stevemance/thumbsup/AM32_IMPLEMENTATION_SUMMARY.md

# AM32 ESC Integration - Implementation Summary

## Overview

Complete AM32 ESC integration with serial configuration, DShot protocol support (framework), and comprehensive documentation.

## What Was Added

### 1. AM32 Serial Configuration Protocol

**Files Created:**
- `firmware/include/am32_config.h` - Protocol definitions and API
- `firmware/src/am32_config.c` - Complete implementation

**Features Implemented:**
- ✅ UART mode switching (PWM ↔ Serial on GP2)
- ✅ ESC information query (`am32_get_info()`)
- ✅ Read/write settings (`am32_read_settings()`, `am32_write_settings()`)
- ✅ Factory reset (`am32_reset_to_defaults()`)
- ✅ Throttle calibration (`am32_calibrate_throttle()`)
- ✅ Bootloader entry for firmware updates (`am32_enter_bootloader()`)
- ✅ USB passthrough mode for external configurators
- ✅ Checksum validation and error handling

**Protocol Details:**
- Baud rate: 19200 (config), 115200 (bootloader)
- Commands: GET_SETTINGS, SET_SETTINGS, GET_INFO, RESET, BOOTLOADER, KEEPALIVE
- EEPROM address-based configuration storage
- XOR checksum validation

### 2. DShot Protocol Support (Framework)

**Files Created:**
- `firmware/include/dshot.h` - DShot protocol API
- `firmware/src/dshot.c` - Implementation framework

**Features Designed:**
- DShot150/300/600/1200 speed support
- Special commands (beeps, direction, LED control, etc.)
- EDT (Extended DShot Telemetry) structure
- Bidirectional telemetry support (RPM, voltage, current, temp)
- CRC-4 calculation
- Throttle conversion utilities

**Status:** Framework complete, PIO implementation pending

**Why DShot:**
- Faster update rate (up to 8kHz vs 50Hz PWM)
- Digital protocol with built-in error detection
- No calibration required
- Bidirectional telemetry on same wire
- More reliable than analog PWM

### 3. Comprehensive Documentation

**Files Created:**
- `docs/AM32_INTEGRATION.md` - Complete integration guide
- `AM32_IMPLEMENTATION_SUMMARY.md` - This file

**Documentation Includes:**
- Architecture diagrams
- Communication modes explanation
- Hardware connection schematics
- API usage examples
- Configuration best practices
- Safety recommendations
- Troubleshooting guide
- Reference links

**Updated:**
- `config/am32/README.md` - Enhanced with protocol details
- `hardware/schematics/thumbsup.kicad_sch` - Added AM32 ESC notes

### 4. Configuration Management

**Existing (Enhanced):**
- `config/am32/weapon_esc_config.json` - Recommended ESC settings
- Default weapon configuration in code

**Settings Managed:**
```c
typedef struct {
    // Basic settings
    uint8_t motor_direction;
    uint8_t bidirectional;
    uint8_t brake_on_stop;      // CRITICAL: Always OFF for weapons
    
    // Motor settings
    uint8_t startup_power;
    uint8_t motor_timing;       // Tune for your motor
    uint16_t motor_kv;
    uint8_t motor_poles;
    
    // PWM settings
    uint8_t pwm_frequency;
    uint16_t throttle_min;
    uint16_t throttle_max;
    
    // Protection
    uint8_t temperature_limit;
    uint8_t current_limit;
    uint8_t low_voltage_cutoff;
    uint8_t demag_compensation;
    
    // Advanced
    uint8_t sine_mode;
    uint8_t telemetry;
} am32_config_t;
```

## Implementation Approach

### Choice: Custom Implementation vs Submodule

**Decision:** Keep custom implementation, NO submodule of AM32 repo

**Rationale:**
1. AM32 repo is ESC *firmware* (runs ON the ESC)
2. We need *protocol library* (communicate WITH the ESC)
3. Submodule would add:
   - STM32 firmware source (~5MB)
   - ARM toolchain dependencies
   - Multiple MCU target builds
   - Files we don't need

**What We Did Instead:**
- Implemented protocol from spec
- Added reference links to upstream
- Documented version sync (AM32 v2.18)
- Clean, lightweight implementation

## Usage Examples

### Configure ESC

```c
#include "am32_config.h"

// Apply defaults and customize
am32_config_t config;
am32_apply_weapon_defaults(&config);
config.motor_kv = 1100;
config.motor_timing = 16;
config.current_limit = 40;

// Write to ESC
if (am32_write_settings(&config)) {
    am32_save_settings();  // Persist to EEPROM
}
```

### Query ESC Info

```c
am32_info_t info;
if (am32_get_info(&info)) {
    printf("ESC: %s v%d.%d.%d\n",
           info.firmware_name,
           info.firmware_version[0],
           info.firmware_version[1],
           info.firmware_version[2]);
}
```

### External Configurator (Passthrough)

```c
// Pico becomes USB-to-UART bridge
am32_passthrough_mode();  // ESC key to exit

// Now connect with AM32 Configurator software
```

### Future: DShot with Telemetry

```c
// Initialize DShot (when PIO implementation complete)
dshot_config_t dshot_cfg = {
    .gpio_pin = PIN_WEAPON_PWM,
    .speed = DSHOT_SPEED_300,
    .bidirectional = true,
    .pole_pairs = 7  // 14 poles / 2
};
dshot_init(MOTOR_WEAPON, &dshot_cfg);

// Send throttle
dshot_send_throttle(MOTOR_WEAPON, 1024, true);  // 50% + request telemetry

// Read telemetry
dshot_telemetry_t telem;
if (dshot_read_telemetry(MOTOR_WEAPON, &telem)) {
    uint16_t rpm = dshot_erpm_to_rpm(telem.erpm, 7);
    printf("Weapon: %d RPM, %.1fV, %.1fA\n",
           rpm,
           telem.voltage_cV / 100.0f,
           telem.current_cA / 100.0f);
}
```

## File Structure

```
firmware/
  include/
    am32_config.h          # AM32 protocol (NEW)
    dshot.h                # DShot protocol (NEW)
  src/
    am32_config.c          # Serial config implementation (NEW)
    dshot.c                # DShot framework (NEW)

config/am32/
  weapon_esc_config.json   # ESC settings (EXISTING)
  README.md                # Setup guide (ENHANCED)

docs/
  AM32_INTEGRATION.md      # Integration guide (NEW)

hardware/schematics/
  thumbsup.kicad_sch       # Updated with AM32 notes (UPDATED)

AM32_IMPLEMENTATION_SUMMARY.md  # This file (NEW)
```

## Build Integration

**CMakeLists.txt Updated:**
```cmake
set(CORE_SOURCES
    ...
    src/am32_config.c
    src/dshot.c     # Added
    ...
)
```

**Build Status:** ✅ Compiles successfully

## Testing Checklist

### AM32 Serial Protocol
- [ ] Enter/exit config mode
- [ ] Read ESC info
- [ ] Read current settings
- [ ] Write new settings
- [ ] Save to EEPROM
- [ ] Calibrate throttle range
- [ ] Factory reset
- [ ] Bootloader entry (firmware update)
- [ ] Passthrough with AM32 Configurator

### DShot (When PIO Complete)
- [ ] DShot300 signal generation
- [ ] Throttle control
- [ ] Special commands (beep, direction)
- [ ] EDT telemetry reception
- [ ] RPM reading
- [ ] Voltage/current/temp monitoring
- [ ] CRC validation

## Safety Considerations

⚠️ **CRITICAL**: Always disable `brake_on_stop` for weapon motors
- Active braking can damage weapon or robot
- Set `config.brake_on_stop = 0`

⚠️ **Power Management**:
- Use 1000μF low-ESR capacitor on ESC power input
- Handles weapon spin-up current spikes
- Prevents brownouts and ESC damage

⚠️ **Calibration**:
- Always calibrate with motor disconnected
- Verify 1000μs = stop, 2000μs = full speed

## Future Enhancements

### Short Term
1. Complete PIO-based DShot implementation
2. EDT telemetry parsing
3. Integrate telemetry with status LEDs
4. Automatic ESC detection

### Long Term
1. MSP protocol wrapper for compatibility
2. Firmware update via Pico
3. Battery voltage compensation
4. Adaptive motor timing tuning

## References

- **AM32 Project**: https://github.com/AlkaMotors/AM32-MultiRotor-ESC-firmware
- **Protocol Spec**: https://github.com/AlkaMotors/AM32-MultiRotor-ESC-firmware/wiki/Serial-Protocol
- **DShot Spec**: https://github.com/betaflight/betaflight/wiki/DSHOT-ESC-Protocol
- **RP2040 PIO Guide**: https://www.raspberrypi.com/documentation/pico-sdk/hardware.html#hardware_pio

## Version History

- **v1.0** (2024-11-18): Initial implementation
  - AM32 serial protocol complete
  - DShot framework created
  - Comprehensive documentation added
  - Build integration complete

---

**Implementation by:** Claude Code + User Collaboration
**Project:** ThumbsUp Combat Robot
**Date:** November 18, 2024
