stevemance/thumbsup/docs/safety_procedures.md

# Safety Procedures - ThumbsUp Combat Robot

## ⚠️ CRITICAL SAFETY INFORMATION

Combat robots contain dangerous spinning weapons and high-energy batteries. Follow ALL safety procedures to prevent injury or property damage.

## Pre-Operation Safety Checklist

### Before Every Session

- [ ] **Visual Inspection**
  - Check for loose components
  - Verify weapon is secure
  - Inspect wiring for damage
  - Check battery for swelling/damage

- [ ] **Safety Equipment**
  - Safety glasses/goggles ON
  - Closed-toe shoes required
  - Long pants recommended
  - Remove loose jewelry

- [ ] **Environment Check**
  - Clear area of people/pets
  - Use proper test box or arena
  - Have fire extinguisher ready (Class D for LiPo)
  - Emergency stop accessible

- [ ] **Battery Safety**
  - Check voltage (>10V for 3S)
  - Inspect for physical damage
  - Proper connector engagement
  - Temperature normal

## Power-On Procedure

### Safe Startup Sequence

1. **Initial Power** (Weapon Disconnected):
   ```
   1. Ensure weapon ESC is unpowered
   2. Connect main battery
   3. Verify status LEDs
   4. Check Bluetooth connection
   5. Test drive functions
   ```

2. **Weapon Connection**:
   ```
   1. Place robot in test box
   2. Clear surrounding area
   3. Connect weapon ESC power
   4. Stand clear (minimum 3 feet)
   5. Verify failsafe works
   ```

3. **Arming Sequence**:
   ```
   1. Hold gamepad X + Y buttons
   2. Wait for armed LED
   3. Check armed indicator flashing
   4. Test at low throttle first
   ```

## Operating Safety Rules

### ALWAYS

✅ **DO**:
- Keep weapon pointed away from people
- Maintain safe distance (3+ feet)
- Use emergency stop if unsure
- Power down when not competing
- Have spotter present
- Communicate clearly with others

### NEVER

❌ **DON'T**:
- Bypass safety features
- Operate without test box/arena
- Leave armed unattended
- Touch moving parts
- Disable failsafes
- Operate with damaged components

## Emergency Procedures

### Emergency Stop Methods

1. **Software E-Stop**:
   - Press L1 + R1 simultaneously
   - Immediately disarms weapon
   - Stops all motors

2. **Connection Loss**:
   - Turn off gamepad
   - 500ms failsafe triggers
   - All motors stop

3. **Physical Disconnect**:
   - Pull main battery connector
   - Last resort method
   - Use if other methods fail

### Fire Response

**LiPo Battery Fire**:
1. Do NOT use water
2. Use Class D extinguisher or sand
3. Move to safe outdoor area if possible
4. Call emergency services if severe
5. Allow to burn out in safe location

### Injury Protocol

1. **Stop all robot operation immediately**
2. Assess injury severity
3. Apply first aid as needed
4. Seek medical attention for:
   - Any cuts from weapon
   - Burns from batteries/ESCs
   - Eye injuries

## Battery Safety

### Charging

- Use LiPo-specific charger only
- Never exceed 1C charge rate
- Monitor during charging
- Charge in fireproof bag/container
- Balance charge regularly

### Storage

- Store at 3.7-3.8V per cell
- Cool, dry location
- Fireproof container
- Check monthly
- Dispose of damaged batteries properly

### Warning Signs

**Stop using battery if**:
- Swelling/puffing visible
- Physical damage present
- Voltage imbalance >0.1V
- Gets hot during use
- Won't hold charge

## Competition Safety

### Pre-Match

1. **Tech Inspection**:
   - Have safety equipment ready
   - Demonstrate failsafe
   - Show emergency stop
   - Verify weight compliance

2. **Staging Area**:
   - Keep weapon disarmed
   - Point weapon down/away
   - Maintain control at all times
   - Communicate with staff

### During Match

1. **Safe Operation**:
   - Follow referee commands
   - Stop on "STOP" call
   - No post-match movement
   - Wait for clear signal

2. **Post-Match**:
   - Disarm immediately
   - Wait for referee clearance
   - Check for damage
   - Safe removal from arena

## Maintenance Safety

### Working on Robot

1. **Power Off Completely**:
   - Disconnect battery
   - Discharge capacitors
   - Verify with multimeter

2. **Weapon Handling**:
   - Remove weapon disk/bar
   - Secure motor shaft
   - Work with motor disconnected

3. **Electrical Work**:
   - One hand rule when testing
   - Insulated tools
   - Check twice, connect once

## Training Requirements

### New Operators Must

1. Read all documentation
2. Watch experienced operator
3. Practice with weapon disabled
4. Demonstrate failsafe operation
5. Pass safety quiz
6. Supervised first operations

## Safety Equipment List

### Required

- Safety glasses/goggles
- Closed-toe shoes
- Test box or arena
- Fire extinguisher (Class D)
- First aid kit
- LiPo charging bag

### Recommended

- Face shield
- Kevlar gloves
- Leather apron
- Multimeter
- Insulated tools
- Warning signs/cones

## Failsafe Testing

### Weekly Test Procedure

1. **Connection Loss Test**:
   ```
   - Arm robot (in test box)
   - Turn off controller
   - Verify stop within 500ms
   - Check all motors stopped
   ```

2. **Emergency Stop Test**:
   ```
   - Operate at low speed
   - Press L1 + R1
   - Verify immediate stop
   - Check disarm successful
   ```

3. **Battery Monitor Test**:
   ```
   - Use variable power supply
   - Reduce voltage to 9.5V
   - Verify low battery warning
   - Check auto-disarm at 9.0V
   ```

## Incident Reporting

### Document Any

- Near misses
- Equipment failures
- Unexpected behavior
- Safety violations
- Injuries (even minor)

### Report Format

```
Date/Time:
Location:
People Present:
Description:
Root Cause:
Corrective Action:
```

## Safety Sign-Off

By operating this robot, you acknowledge:

- [ ] I have read all safety procedures
- [ ] I understand the risks involved
- [ ] I will follow all safety rules
- [ ] I will report any incidents
- [ ] I will not bypass safety features
- [ ] I accept responsibility for safe operation

---

**Remember**: No competition or testing is worth an injury. When in doubt, STOP and reassess.

**Emergency Contacts**:
- Local Emergency: 911
- Poison Control (battery): 1-800-222-1222
- Event Safety Officer: [Event Specific]

---

Safety is everyone's responsibility. Stay alert, stay safe!
