stevemance/thumbsup/firmware/tests/README.md

# Firmware One-Off Tests

This directory contains standalone firmware images for bench testing.
These are not part of the competition firmware and may bypass safety interlocks.

## Build

```bash
export PICO_SDK_PATH=/path/to/pico-sdk
cd firmware/tests
mkdir -p build && cd build
cmake ..
make dshot_beep_test dshot_spin_test dshot_telemetry_spin_test dshot_telemetry_hold_test dshot_telemetry_single_rpm_test dshot_telemetry_calibration_test am32_onewire_probe
```

## Flash (example)

```bash
picotool reboot -f -u
picotool load -x firmware/tests/build/dshot_spin_test.uf2
```

## Notes

- DShot tests use GP4 (PIN_WEAPON_PWM) and DShot300.
- Bidirectional telemetry is disabled in the spin test for stability.
- Use `dshot_telemetry_spin_test` for bidirectional telemetry experiments.
- Use `dshot_telemetry_hold_test` for a single-throttle hold window.
- Use `dshot_telemetry_single_rpm_test` for a fixed-throttle RPM + PSU current window.
- Use `dshot_telemetry_calibration_test` for multi-step throttle calibration holds.
- Use `am32_onewire_probe` to read AM32 settings over the single signal wire.
