stevemance/thumbsup/firmware/src/main.c

#include <stdio.h>
#include <stdlib.h>
#include <string.h>
#include <pico/stdlib.h>
#include <hardware/gpio.h>
#include <hardware/adc.h>
#include <hardware/watchdog.h>
#include "config.h"
#include "drive_hbridge.h"
#include "motor_control.h"
#include "drive.h"
#include "weapon.h"
#include "safety.h"
#include "status.h"
#include "am32_config.h"
#include "safety_test.h"
#include "integration_test.h"
#include "serial_gamepad.h"
#include "test_mode.h"
#include "hitl_overrides.h"

// Competition mode (Bluetooth) - diagnostic mode removed
#if !SERIAL_GAMEPAD
#include <pico/cyw43_arch.h>
#include <btstack_run_loop.h>
#include <uni.h>
#include "sdkconfig.h"
// Sanity check
#ifndef CONFIG_BLUEPAD32_PLATFORM_CUSTOM
#error "Pico W must use BLUEPAD32_PLATFORM_CUSTOM"
#endif
// Defined in bluetooth_platform.c
struct uni_platform* get_my_platform(void);
#endif

// Robot state is now managed in bluetooth_platform.c

static void init_hardware(void) {
    // Note: stdio_init_all() is called in main() before this function

#if BATTERY_ADC_ENABLED && !DRIVE_HBRIDGE
    adc_init();
    adc_gpio_init(PIN_BATTERY_ADC);
    adc_select_input(0);
#endif

#if SAFETY_BUTTON_ENABLED
    gpio_init(PIN_SAFETY_BUTTON);
    gpio_set_dir(PIN_SAFETY_BUTTON, GPIO_IN);
    gpio_pull_up(PIN_SAFETY_BUTTON);
#endif

#if !SERIAL_GAMEPAD
    printf("\n=================================\n");
    printf("  %s Combat Robot\n", ROBOT_NAME);
    printf("  Firmware v%s\n", FIRMWARE_VERSION);
    printf("=================================\n\n");
#endif

}

uint32_t read_battery_voltage(void) {
    uint32_t override_mv = 0;
    if (hitl_overrides_get_battery_mv(&override_mv)) {
        return override_mv;
    }

#if !BATTERY_ADC_ENABLED
    return BATTERY_MAX_VOLTAGE;  // ADC not wired — report nominal full voltage
#elif DRIVE_HBRIDGE
    // The drive module owns the ADC (round robin with the current senses).
    return drive_hb_battery_mv();
#endif

    uint16_t adc_raw = adc_read();

    // SAFETY: Validate ADC reading and prevent overflow
    if (adc_raw > 4095) {
        DEBUG_PRINT("WARNING: Invalid ADC reading %u\n", adc_raw);
        adc_raw = 4095;
    }

    // Use double precision to prevent intermediate overflow
    double voltage = ((double)adc_raw * BATTERY_ADC_SCALE / 4095.0) * BATTERY_DIVIDER * 1000.0;

    // SAFETY: Clamp result to reasonable range before converting to int
    if (voltage < 0.0) voltage = 0.0;
    if (voltage > 20000.0) voltage = 20000.0; // Max 20V for safety

    return (uint32_t)voltage;
}

// Battery monitoring and status functions moved to bluetooth_platform.c

static void check_config_mode_entry(void) {
    // Enter config mode if safety button held during boot
#if SAFETY_BUTTON_ENABLED
    if (!gpio_get(PIN_SAFETY_BUTTON)) {
#else
    if (false) {
#endif
        printf("\n=================================\n");
        printf("  AM32 Configuration Mode\n");
        printf("=================================\n\n");

        am32_init();

        printf("Options:\n");
        printf("1. Press 'C' to configure ESC\n");
        printf("2. Press 'P' for passthrough mode\n");
        printf("3. Press 'T' for throttle calibration\n");
        printf("4. Press 'D' to apply defaults\n");
        printf("5. Press any other key to exit\n\n");

        int c = getchar();

        switch (c) {
            case 'C':
            case 'c': {
                printf("Configuring AM32 ESC with weapon defaults...\n");
                am32_config_t config;
                am32_apply_weapon_defaults(&config);

                if (am32_enter_config_mode()) {
                    if (am32_write_settings(&config)) {
                        am32_save_settings();
                        printf("Configuration complete!\n");
                    } else {
                        printf("Configuration failed!\n");
                    }
                    am32_exit_config_mode();
                }
                break;
            }

            case 'P':
            case 'p':
                printf("Entering passthrough mode (ESC to exit)...\n");
                am32_passthrough_mode();
                break;

            case 'T':
            case 't':
                printf("Starting throttle calibration...\n");
                if (am32_enter_config_mode()) {
                    am32_calibrate_throttle();
                    am32_exit_config_mode();
                }
                break;

            case 'D':
            case 'd': {
                printf("Applying default weapon settings...\n");
                am32_config_t default_config;
                am32_apply_weapon_defaults(&default_config);
                if (am32_enter_config_mode()) {
                    am32_write_settings(&default_config);
                    am32_save_settings();
                    am32_exit_config_mode();
                }
                printf("Defaults applied!\n");
                break;
            }

            default:
                printf("Exiting config mode...\n");
                break;
        }

        printf("\nContinuing to normal operation...\n\n");
        sleep_ms(1000);
    }
}

int main() {
    stdio_init_all();

    // Wait a bit for USB connection
    sleep_ms(2000);

#if !SERIAL_GAMEPAD
    printf("\n\n*** MAIN STARTING ***\n");
    printf("Build mode: COMPETITION\n");
    printf("Motor output disabled: %d\n", DISABLE_MOTOR_OUTPUT);
#endif

    init_hardware();

#if INTEGRATION_TEST_AUTO
    printf("\n=================================\n");
    printf("  INTEGRATION TEST BUILD\n");
    printf("=================================\n\n");
    printf("Skipping Bluetooth/WiFi init\n");
#elif SERIAL_GAMEPAD
    // SERIAL_GAMEPAD build: skip Bluetooth/WiFi init quietly to avoid blocking USB output.
#else
    #if BUILD_MODE_DIAGNOSTIC
        // DIAGNOSTIC MODE BUILD

        // Wait for USB serial connection
        for (int i = 0; i < 3; i++) {
            printf("Starting diagnostic mode in %d...\n", 3-i);
            sleep_ms(1000);
        }

        printf("\n=================================\n");
        printf("  DIAGNOSTIC MODE BUILD\n");
        printf("=================================\n\n");

        // Initialize for WiFi (diagnostic mode)
        if (cyw43_arch_init_with_country(CYW43_COUNTRY_USA)) {
            printf("Failed to initialize WiFi\n");
            return -1;
        }
        printf("WiFi initialized for diagnostic mode\n");
    #else
        // COMPETITION MODE BUILD
        printf("\n=================================\n");
        printf("  COMPETITION MODE BUILD\n");
        printf("=================================\n\n");

        // Initialize for Bluetooth (competition mode)
        if (cyw43_arch_init()) {
            printf("Failed to initialize Bluetooth\n");
            return -1;
        }
        printf("Bluetooth initialized for competition mode\n");
    #endif

    // Turn-on LED. Turn it off once init is done.
    cyw43_arch_gpio_put(CYW43_WL_GPIO_LED_PIN, 1);
#endif

    // COMPETITION MODE - Run Bluetooth gamepad control
#if !SERIAL_GAMEPAD
        printf("\n*** COMPETITION MODE ***\n");
        printf("Starting Bluetooth initialization...\n");
#endif

        // Check if we should enter AM32 config mode
#if !SERIAL_GAMEPAD
        printf("Checking for config mode...\n");
        check_config_mode_entry();
#endif

        // Initialize AM32 config
#if !SERIAL_GAMEPAD
        printf("Initializing AM32...\n");
#endif
        am32_init();

        // Initialize motor control system before safety tests
#if !SERIAL_GAMEPAD
        printf("Initializing motor control system...\n");
#endif
        #if SERIAL_GAMEPAD
        test_mode_init();
        #endif
        motor_control_init();

        // Initialize other subsystems needed for tests
        weapon_init();
        drive_init();
        safety_init();
        #if !INTEGRATION_TEST_AUTO
        status_init();
        #endif

        // SAFETY: Run comprehensive safety tests
#if !SERIAL_GAMEPAD
        printf("Running safety validation tests...\n");
        if (!run_safety_tests()) {
            printf("\n*** CRITICAL SAFETY FAILURE ***\n");
            printf("Robot safety tests failed!\n");
            printf("DO NOT OPERATE - SYSTEM UNSAFE\n");
            printf("*******************************\n\n");

            // Flash all LEDs rapidly to indicate unsafe condition
            status_emergency_flash();
            while (true) {
                status_update();
                sleep_ms(50);
            }
        }
        printf("Safety tests passed - system ready\n");
#endif

#if !SERIAL_GAMEPAD
        if (integration_test_run_if_requested(5000)) {
            printf("Integration test complete - halting normal startup\n");
            while (true) {
                status_update();
                sleep_ms(100);
            }
        }
#endif

#if SERIAL_GAMEPAD
        serial_gamepad_init();
        uint32_t last_status_ms = 0;

        while (true) {
            serial_gamepad_poll();
            motor_control_update();
            weapon_update();
            uint32_t now_ms = to_ms_since_boot(get_absolute_time());
            if ((now_ms - last_status_ms) >= STATUS_UPDATE_RATE) {
                status_update();
                last_status_ms = now_ms;
            }
            safety_update();
            sleep_ms(MAIN_LOOP_DELAY);
        }
#else
        // Must be called before uni_init()
        uni_platform_set_custom(get_my_platform());

        // Initialize BP32
        printf("About to call uni_init()...\n");
        uni_init(0, NULL);
        printf("uni_init() completed successfully\n");

        printf("ThumbsUp robot initialized. Starting Bluepad32...\n");

        // Don't enable watchdog yet - wait for first controller connection
        // The bluetooth_platform.c will enable it after first gamepad connects
        printf("Watchdog will be enabled after first controller connection\n");

        // Turn off onboard LED
        cyw43_arch_gpio_put(CYW43_WL_GPIO_LED_PIN, 0);

        // Does not return - BTstack takes over
        btstack_run_loop_execute();
#endif

    return 0;
}
