stevemance/thumbsup/firmware/src/motor_control.c

#include "motor_control.h"
#include "config.h"
#include "system_status.h"
#include "hardware/pwm.h"
#include "hardware/clocks.h"
#include "hardware/gpio.h"
#if DRIVE_HBRIDGE
#include "drive_hbridge.h"
#endif
#include <stdio.h>
#include <stdlib.h>

static motor_config_t motors[MOTOR_COUNT];
static bool initialized = false;

static uint16_t speed_to_pulse(int8_t speed) {
    // SAFETY: Clamp input to prevent overflow
    speed = CLAMP(speed, -100, 100);

    const int16_t mid_pulse = PWM_NEUTRAL_PULSE;

    if (speed == 0) {
        return mid_pulse;
    }

    // SAFETY: Use 32-bit arithmetic to prevent overflow, then clamp result
    if (speed > 0) {
        int32_t pulse = mid_pulse + ((int32_t)speed * (PWM_MAX_PULSE - mid_pulse)) / 100;
        return (uint16_t)CLAMP(pulse, PWM_MIN_PULSE, PWM_MAX_PULSE);
    } else {
        int32_t pulse = mid_pulse + ((int32_t)speed * (mid_pulse - PWM_MIN_PULSE)) / 100;
        return (uint16_t)CLAMP(pulse, PWM_MIN_PULSE, PWM_MAX_PULSE);
    }
}

#if DRIVE_HBRIDGE
// Drive channels keep their servo-pulse interface (1000..2000 us, 1500 =
// stop) so callers are unchanged; the pulse maps linearly onto H-bridge duty.
static void hb_apply(motor_channel_t channel, uint16_t pulse_us) {
    if (channel == MOTOR_LEFT_DRIVE || channel == MOTOR_RIGHT_DRIVE) {
        drive_hb_set(channel, (int16_t)(((int32_t)pulse_us - PWM_NEUTRAL_PULSE) * 2));
    }
}
#endif

static void setup_pwm_pin(uint8_t pin, uint8_t* slice, uint8_t* channel) {
    // SAFETY: Validate pointer parameters
    if (slice == NULL || channel == NULL) {
        DEBUG_PRINT("CRITICAL: NULL pointer passed to setup_pwm_pin\n");
        return;
    }

    gpio_set_function(pin, GPIO_FUNC_PWM);
    *slice = pwm_gpio_to_slice_num(pin);
    *channel = pwm_gpio_to_channel(pin);

    pwm_config cfg = pwm_get_default_config();

    pwm_config_set_clkdiv(&cfg, (float)clock_get_hz(clk_sys) / PWM_TICK_HZ);
    pwm_config_set_wrap(&cfg, PWM_WRAP_VALUE - 1);

    pwm_init(*slice, &cfg, false);
}

static void init_weapon_pwm_disabled(void) {
    gpio_set_function(PIN_WEAPON_PWM, GPIO_FUNC_SIO);
    gpio_set_dir(PIN_WEAPON_PWM, GPIO_IN);
    gpio_pull_up(PIN_WEAPON_PWM);
}

bool motor_control_init(void) {
    if (initialized) {
        return true;
    }

#if DRIVE_HBRIDGE
    drive_hb_init();
    motors[MOTOR_LEFT_DRIVE].gpio_pin = PIN_HB_LEFT_IN1;
    motors[MOTOR_LEFT_DRIVE].reversed = false;
    motors[MOTOR_LEFT_DRIVE].pwm_enabled = false;   // owned by drive_hbridge
    motors[MOTOR_RIGHT_DRIVE].gpio_pin = PIN_HB_RIGHT_IN1;
    motors[MOTOR_RIGHT_DRIVE].reversed = true;  // Reversed because motor is mounted facing opposite direction
    motors[MOTOR_RIGHT_DRIVE].pwm_enabled = false;
#else
    motors[MOTOR_LEFT_DRIVE].gpio_pin = PIN_DRIVE_LEFT_PWM;
    motors[MOTOR_LEFT_DRIVE].reversed = false;
    setup_pwm_pin(PIN_DRIVE_LEFT_PWM,
                  &motors[MOTOR_LEFT_DRIVE].pwm_slice,
                  &motors[MOTOR_LEFT_DRIVE].pwm_channel);
    motors[MOTOR_LEFT_DRIVE].pwm_enabled = true;

    motors[MOTOR_RIGHT_DRIVE].gpio_pin = PIN_DRIVE_RIGHT_PWM;
    motors[MOTOR_RIGHT_DRIVE].reversed = true;  // Reversed because motor is mounted facing opposite direction
    setup_pwm_pin(PIN_DRIVE_RIGHT_PWM,
                  &motors[MOTOR_RIGHT_DRIVE].pwm_slice,
                  &motors[MOTOR_RIGHT_DRIVE].pwm_channel);
    motors[MOTOR_RIGHT_DRIVE].pwm_enabled = true;
#endif

    motors[MOTOR_WEAPON].gpio_pin = PIN_WEAPON_PWM;
    motors[MOTOR_WEAPON].reversed = false;
    motors[MOTOR_WEAPON].pwm_slice = 0;
    motors[MOTOR_WEAPON].pwm_channel = 0;
    motors[MOTOR_WEAPON].pwm_enabled = false;
    init_weapon_pwm_disabled();

    // CRITICAL SAFETY: Initialize all motors to safe states
    for (int i = 0; i < MOTOR_COUNT; i++) {
        if (i == MOTOR_WEAPON) {
            // Weapon motor MUST start with minimum pulse (off)
            motors[i].current_pulse_us = PWM_MIN_PULSE;
            motors[i].target_pulse_us = PWM_MIN_PULSE;
        } else {
            // Drive motors start at neutral (stopped)
            motors[i].current_pulse_us = PWM_NEUTRAL_PULSE;
            motors[i].target_pulse_us = PWM_NEUTRAL_PULSE;
        }
        if (motors[i].pwm_enabled) {
            uint32_t pulse_cycles = motors[i].current_pulse_us;
            #if !DISABLE_MOTOR_OUTPUT
            pwm_set_chan_level(motors[i].pwm_slice, motors[i].pwm_channel, pulse_cycles);
            #else
            printf("MOTOR: Would set %d to %d cycles (DISABLED)\n", i, pulse_cycles);
            #endif
            pwm_set_enabled(motors[i].pwm_slice, true);
        }
    }

    initialized = true;
    DEBUG_PRINT("Motor control initialized\n");

    return true;
}

bool motor_control_update(void) {
#if DRIVE_HBRIDGE
    drive_hb_update();
#endif
    if (!initialized) {
        return false;
    }

    for (int i = 0; i < MOTOR_COUNT; i++) {
        if (!motors[i].pwm_enabled) {
            continue;
        }
        if (motors[i].current_pulse_us != motors[i].target_pulse_us) {
            int16_t diff = motors[i].target_pulse_us - motors[i].current_pulse_us;
            int16_t step = 10;

            if (abs(diff) <= step) {
                motors[i].current_pulse_us = motors[i].target_pulse_us;
            } else if (diff > 0) {
                motors[i].current_pulse_us += step;
            } else {
                motors[i].current_pulse_us -= step;
            }

            uint32_t pulse_cycles = motors[i].current_pulse_us;
            #if !DISABLE_MOTOR_OUTPUT
            pwm_set_chan_level(motors[i].pwm_slice, motors[i].pwm_channel, pulse_cycles);
            #else
            // Log what we would be sending for testing
            if (motors[i].current_pulse_us != PWM_NEUTRAL_PULSE && i != MOTOR_WEAPON) {
                printf("MOTOR %d: %dus\n", i, motors[i].current_pulse_us);
            } else if (i == MOTOR_WEAPON && motors[i].current_pulse_us != PWM_MIN_PULSE) {
                printf("WEAPON: %dus\n", motors[i].current_pulse_us);
            }
            #endif
        }
    }

    return true;
}

// Changes the drive PWM frame rate at runtime (HITL experiments).  Pulse widths
// stay in microseconds, so only the frame period changes.
bool motor_control_set_drive_frame_rate(uint32_t hz) {
    if (!initialized || hz < 50 || hz > 490 || DRIVE_HBRIDGE) {
        return false;
    }
    const motor_channel_t drive[] = {MOTOR_LEFT_DRIVE, MOTOR_RIGHT_DRIVE};
    for (int i = 0; i < 2; i++) {
        pwm_set_wrap(motors[drive[i]].pwm_slice, (uint16_t)(PWM_TICK_HZ / hz - 1));
    }
    return true;
}

bool motor_control_set_pulse(motor_channel_t channel, uint16_t pulse_us) {
    if (!initialized || channel >= MOTOR_COUNT) {
        DEBUG_PRINT("Motor control error: invalid channel %d\n", channel);
        return false;
    }

    if (channel == MOTOR_WEAPON && !motors[channel].pwm_enabled) {
        motors[channel].current_pulse_us = PWM_MIN_PULSE;
        motors[channel].target_pulse_us = PWM_MIN_PULSE;
        return false;
    }

    // SAFETY: Additional validation for weapon motor
    if (channel == MOTOR_WEAPON) {
        // Weapon motor can only receive MIN_PULSE (off) when not properly armed
        if (system_failsafe_active() || !system_is_armed()) {
            if (pulse_us != PWM_MIN_PULSE) {
                DEBUG_PRINT("SAFETY: Weapon pulse blocked - not armed or failsafe active\n");
                pulse_us = PWM_MIN_PULSE;
            }
        }
    }

    // Strict pulse validation with logging
    if (pulse_us < PWM_MIN_PULSE || pulse_us > PWM_MAX_PULSE) {
        DEBUG_PRINT("Motor control error: invalid pulse %d for channel %d\n", pulse_us, channel);
        pulse_us = CLAMP(pulse_us, PWM_MIN_PULSE, PWM_MAX_PULSE);
    }

    // Apply immediately.  The drive ESCs get the new width at the next PWM
    // frame; any ramping here adds directly to stick-to-wheel latency.
    motors[channel].target_pulse_us = pulse_us;
#if DRIVE_HBRIDGE
    if (channel != MOTOR_WEAPON) {
        motors[channel].current_pulse_us = pulse_us;
        #if !DISABLE_MOTOR_OUTPUT
        hb_apply(channel, pulse_us);
        #endif
        return true;
    }
#endif
    if (motors[channel].pwm_enabled && motors[channel].current_pulse_us != pulse_us) {
        motors[channel].current_pulse_us = pulse_us;
        #if !DISABLE_MOTOR_OUTPUT
        pwm_set_chan_level(motors[channel].pwm_slice, motors[channel].pwm_channel, pulse_us);
        #endif
    }

    return true;
}

bool motor_control_set_speed(motor_channel_t channel, int8_t speed) {
    if (!initialized || channel >= MOTOR_COUNT) {
        return false;
    }

    int8_t original_speed = speed;
    speed = CLAMP(speed, -100, 100);

    if (motors[channel].reversed) {
        speed = -speed;
    }

    uint16_t pulse = speed_to_pulse(speed);

#ifdef DEBUG_MODE
    // DEBUG: Log motor commands (only for drive motors)
    static uint32_t last_motor_debug = 0;
    uint32_t now = to_ms_since_boot(get_absolute_time());
    if (now - last_motor_debug > 500 && channel < MOTOR_WEAPON) {
        if (original_speed != 0) {
            const char* name = (channel == MOTOR_LEFT_DRIVE) ? "LEFT" : "RIGHT";
            printf("MOTOR %s: speed=%d pulse=%dus\n", name, speed, pulse);
        }
        if (channel == MOTOR_RIGHT_DRIVE) {
            last_motor_debug = now;
        }
    }
#endif

    return motor_control_set_pulse(channel, pulse);
}

void motor_control_stop_all(void) {
    if (!initialized) {
        return;
    }

    for (int i = 0; i < MOTOR_COUNT; i++) {
        if (i == MOTOR_WEAPON) {
            motors[i].target_pulse_us = PWM_MIN_PULSE;
            motors[i].current_pulse_us = PWM_MIN_PULSE;
        } else {
            motors[i].target_pulse_us = PWM_NEUTRAL_PULSE;
            motors[i].current_pulse_us = PWM_NEUTRAL_PULSE;
#if DRIVE_HBRIDGE
            hb_apply((motor_channel_t)i, PWM_NEUTRAL_PULSE);
#endif
        }

        if (motors[i].pwm_enabled) {
            uint32_t pulse_cycles = motors[i].current_pulse_us;
            #if !DISABLE_MOTOR_OUTPUT
            pwm_set_chan_level(motors[i].pwm_slice, motors[i].pwm_channel, pulse_cycles);
            #endif
        }
    }
}

uint16_t motor_control_get_pulse(motor_channel_t channel) {
    if (!initialized || channel >= MOTOR_COUNT) {
        return PWM_NEUTRAL_PULSE;
    }

    return motors[channel].current_pulse_us;
}

uint16_t motor_control_get_target_pulse(motor_channel_t channel) {
    if (!initialized || channel >= MOTOR_COUNT) {
        return PWM_NEUTRAL_PULSE;
    }

    return motors[channel].target_pulse_us;
}

void motor_control_emergency_stop(void) {
    motor_control_stop_all();

    for (int i = 0; i < MOTOR_COUNT; i++) {
        if (motors[i].pwm_enabled) {
            pwm_set_enabled(motors[i].pwm_slice, false);
        }
    }

    initialized = false;
    DEBUG_PRINT("Emergency stop activated!\n");
}

bool motor_control_enable_weapon_pwm(void) {
    if (!initialized) {
        return false;
    }
    if (motors[MOTOR_WEAPON].pwm_enabled) {
        return true;
    }

    setup_pwm_pin(PIN_WEAPON_PWM,
                  &motors[MOTOR_WEAPON].pwm_slice,
                  &motors[MOTOR_WEAPON].pwm_channel);
    motors[MOTOR_WEAPON].pwm_enabled = true;
    motors[MOTOR_WEAPON].current_pulse_us = PWM_MIN_PULSE;
    motors[MOTOR_WEAPON].target_pulse_us = PWM_MIN_PULSE;

    uint32_t pulse_cycles = PWM_MIN_PULSE;
    #if !DISABLE_MOTOR_OUTPUT
    pwm_set_chan_level(motors[MOTOR_WEAPON].pwm_slice,
                       motors[MOTOR_WEAPON].pwm_channel,
                       pulse_cycles);
    #endif
    pwm_set_enabled(motors[MOTOR_WEAPON].pwm_slice, true);
    return true;
}

void motor_control_disable_weapon_pwm(void) {
    if (!initialized) {
        return;
    }
    motors[MOTOR_WEAPON].pwm_enabled = false;
    motors[MOTOR_WEAPON].current_pulse_us = PWM_MIN_PULSE;
    motors[MOTOR_WEAPON].target_pulse_us = PWM_MIN_PULSE;
}
