stevemance/thumbsup/firmware/src/drive.c

#include "drive.h"
#include "motor_control.h"
#include "config.h"
#include <stdio.h>
#include <stdlib.h>
#include <math.h>

static uint8_t current_expo = DRIVE_EXPO;
static bool drive_enabled = false;

int8_t drive_apply_expo(int8_t input, uint8_t expo) {
    // SAFETY: Validate inputs to prevent overflow
    if (input == 0 || expo == 0) {
        return input;
    }

    // Clamp expo to valid range
    expo = expo > 100 ? 100 : expo;

    float normalized = (float)input / 127.0f;
    float expo_factor = (float)expo / 100.0f;

    float linear = normalized;
    float cubic = normalized * normalized * normalized;

    // Cubic of negative is already negative, so no need to invert
    float output = linear * (1.0f - expo_factor) + cubic * expo_factor;

    // SAFETY: Clamp output to valid int8_t range
    float result = output * 127.0f;
    if (result > 127.0f) result = 127.0f;
    if (result < -127.0f) result = -127.0f;

    return (int8_t)result;
}

drive_output_t drive_mix(int8_t forward, int8_t turn) {
    drive_output_t output = {0, 0}; // SAFETY: Initialize to safe defaults

    // SAFETY: Validate inputs
    forward = CLAMP(forward, -127, 127);
    turn = CLAMP(turn, -127, 127);

    int8_t forward_before_expo = forward;
    int8_t turn_before_expo = turn;

    forward = drive_apply_expo(forward, current_expo);
    turn = drive_apply_expo(turn, TURN_EXPO);

#ifdef DEBUG_MODE
    // DEBUG: Log expo transformation
    static uint32_t last_expo_debug = 0;
    uint32_t now = to_ms_since_boot(get_absolute_time());
    if (now - last_expo_debug > 500) {
        if (forward_before_expo != 0 || turn_before_expo != 0) {
            printf("EXPO: F %d→%d, T %d→%d\n",
                   forward_before_expo, forward, turn_before_expo, turn);
        }
        last_expo_debug = now;
    }
#endif

    // SAFETY: Use 32-bit arithmetic to prevent overflow during scaling
    // Input range is -127 to +127, scale to percentage values
    // Forward: scale to -100 to +100 (MAX_DRIVE_SPEED = 100%)
    // Turn: scale to MAX_TURN_SPEED (50% = reduced turn sensitivity for better control)
    int32_t scaled_forward = ((int32_t)forward * MAX_DRIVE_SPEED) / 127;
    int32_t scaled_turn = ((int32_t)turn * MAX_TURN_SPEED) / 127;

    // SAFETY: Clamp after scaling to prevent overflow
    scaled_forward = CLAMP(scaled_forward, -100, 100);
    scaled_turn = CLAMP(scaled_turn, -100, 100);

    int32_t left = scaled_forward + scaled_turn;
    int32_t right = scaled_forward - scaled_turn;

    // SAFETY: Find max value safely
    int32_t max_val = (left < 0 ? -left : left);
    int32_t right_abs = (right < 0 ? -right : right);
    if (right_abs > max_val) max_val = right_abs;

    if (max_val > 100) {
        // SAFETY: Use double precision for scaling calculation
        double scale = 100.0 / (double)max_val;
        left = (int32_t)(left * scale);
        right = (int32_t)(right * scale);
    }

    output.left_speed = (int8_t)CLAMP(left, -100, 100);
    output.right_speed = (int8_t)CLAMP(right, -100, 100);

#ifdef DEBUG_MODE
    // DEBUG: Log final output speeds with real units
    static uint32_t last_mix_debug = 0;
    uint32_t now2 = to_ms_since_boot(get_absolute_time());
    if (now2 - last_mix_debug > 500) {
        if (output.left_speed != 0 || output.right_speed != 0) {
            float left_ms = PWM_PERCENT_TO_MS(output.left_speed);
            float right_ms = PWM_PERCENT_TO_MS(output.right_speed);
            int left_rpm = PWM_PERCENT_TO_RPM(output.left_speed);
            int right_rpm = PWM_PERCENT_TO_RPM(output.right_speed);
            printf("MIX: L=%d%% (%.2fm/s, %dRPM) R=%d%% (%.2fm/s, %dRPM)\n",
                   output.left_speed, left_ms, left_rpm,
                   output.right_speed, right_ms, right_rpm);
        }
        last_mix_debug = now2;
    }
#endif

    return output;
}

bool drive_init(void) {
    drive_enabled = true;
    current_expo = DRIVE_EXPO;

    motor_control_set_speed(MOTOR_LEFT_DRIVE, 0);
    motor_control_set_speed(MOTOR_RIGHT_DRIVE, 0);

    DEBUG_PRINT("Drive system initialized with expo=%d\n", current_expo);

    return true;
}

void drive_update(drive_control_t* control) {
    // SAFETY: Validate input parameters
    if (!control || !drive_enabled) {
        DEBUG_PRINT("Drive update: invalid parameters or disabled\n");
        drive_stop();
        return;
    }

    if (!control->enabled) {
        drive_stop();
        return;
    }

    // SAFETY: Additional validation of control inputs
    if (control->forward < -127 || control->forward > 127 ||
        control->turn < -127 || control->turn > 127) {
        DEBUG_PRINT("Drive update: invalid control values (%d, %d)\n",
                    control->forward, control->turn);
        drive_stop();
        return;
    }

    int8_t forward = control->forward;
    int8_t turn = control->turn;

    drive_output_t output = drive_mix(forward, turn);

    // SAFETY: Verify output is within expected range before sending to motors
    if (output.left_speed < -100 || output.left_speed > 100 ||
        output.right_speed < -100 || output.right_speed > 100) {
        DEBUG_PRINT("CRITICAL: Drive mix produced invalid output (%d, %d)\n",
                    output.left_speed, output.right_speed);
        drive_stop();
        return;
    }

    // Left/right differences (a damaged gearbox) are corrected per motor by
    // drive_hbridge's learned speed matching.
    motor_control_set_speed(MOTOR_LEFT_DRIVE, output.left_speed);
    motor_control_set_speed(MOTOR_RIGHT_DRIVE, output.right_speed);
}

void drive_stop(void) {
    motor_control_set_speed(MOTOR_LEFT_DRIVE, 0);
    motor_control_set_speed(MOTOR_RIGHT_DRIVE, 0);
}

void drive_set_expo(uint8_t expo_value) {
    current_expo = CLAMP(expo_value, 0, 100);
}
