stevemance/thumbsup/firmware/include/dshot.h

#ifndef DSHOT_H
#define DSHOT_H

#include <stdint.h>
#include <stdbool.h>
#include "motor_control.h"
#include "dshot_rx.h"

/**
 * DShot Protocol Implementation
 *
 * DShot is a digital ESC protocol that provides:
 * - More reliable communication than PWM
 * - Bidirectional telemetry (EDT - Extended DShot Telemetry)
 * - RPM, voltage, current, temperature feedback
 * - Faster update rates (up to 8kHz)
 *
 * DShot Frame Structure:
 * - 11 bits throttle value (0-2047)
 * - 1 bit telemetry request
 * - 4 bits CRC
 * Total: 16 bits per frame
 *
 * DShot Speeds:
 * - DShot150: 150kbit/s (6.67μs per bit)
 * - DShot300: 300kbit/s (3.33μs per bit)  ← Recommended for RP2040
 * - DShot600: 600kbit/s (1.67μs per bit)
 * - DShot1200: 1200kbit/s (0.83μs per bit)
 */

// DShot speed configuration
typedef enum {
    DSHOT_SPEED_150  = 150,   // 150kbit/s - most reliable
    DSHOT_SPEED_300  = 300,   // 300kbit/s - recommended
    DSHOT_SPEED_600  = 600,   // 600kbit/s - high performance
    DSHOT_SPEED_1200 = 1200   // 1200kbit/s - maximum speed
} dshot_speed_t;

// DShot special commands (throttle = 0, command in bits)
typedef enum {
    DSHOT_CMD_MOTOR_STOP        = 0,     // Stop motor
    DSHOT_CMD_BEEP1             = 1,     // Beep pattern 1
    DSHOT_CMD_BEEP2             = 2,     // Beep pattern 2
    DSHOT_CMD_BEEP3             = 3,     // Beep pattern 3
    DSHOT_CMD_BEEP4             = 4,     // Beep pattern 4
    DSHOT_CMD_BEEP5             = 5,     // Beep pattern 5
    DSHOT_CMD_ESC_INFO          = 6,     // Request ESC info
    DSHOT_CMD_SPIN_DIRECTION_1  = 7,     // Rotate direction 1
    DSHOT_CMD_SPIN_DIRECTION_2  = 8,     // Rotate direction 2
    DSHOT_CMD_3D_MODE_OFF       = 9,     // Disable 3D mode
    DSHOT_CMD_3D_MODE_ON        = 10,    // Enable 3D mode
    DSHOT_CMD_SETTINGS_REQUEST  = 11,    // Request settings
    DSHOT_CMD_SAVE_SETTINGS     = 12,    // Save settings to EEPROM
    DSHOT_CMD_EXTENDED_TELEMETRY_ENABLE  = 13, // Enable extended telemetry
    DSHOT_CMD_EXTENDED_TELEMETRY_DISABLE = 14, // Disable extended telemetry
    DSHOT_CMD_SPIN_DIRECTION_NORMAL   = 20,  // Normal rotation
    DSHOT_CMD_SPIN_DIRECTION_REVERSED = 21,  // Reversed rotation
    DSHOT_CMD_LED0_ON           = 22,    // LED 0 on
    DSHOT_CMD_LED1_ON           = 23,    // LED 1 on
    DSHOT_CMD_LED2_ON           = 24,    // LED 2 on
    DSHOT_CMD_LED3_ON           = 25,    // LED 3 on
    DSHOT_CMD_LED0_OFF          = 26,    // LED 0 off
    DSHOT_CMD_LED1_OFF          = 27,    // LED 1 off
    DSHOT_CMD_LED2_OFF          = 28,    // LED 2 off
    DSHOT_CMD_LED3_OFF          = 29,    // LED 3 off
    DSHOT_CMD_AUDIO_STREAM      = 30,    // Audio stream mode
    DSHOT_CMD_SILENT_MODE       = 31,    // Silent mode
} dshot_command_t;

// EDT (Extended DShot Telemetry) frame structure
typedef struct {
    uint32_t erpm;              // Electrical RPM (mechanical RPM × pole pairs)
    uint16_t voltage_cV;        // Voltage in centi-volts (12.6V = 1260)
    uint16_t current_cA;        // Current in centi-amps (10.5A = 1050)
    uint8_t temperature_C;      // Temperature in Celsius
    uint8_t crc;                // CRC checksum
    bool valid;                 // True if telemetry is valid
    uint32_t timestamp_ms;      // When telemetry was received
    uint8_t type;               // Kind of the most recent frame (dshot_frame_kind_t)
    uint16_t value;             // Raw 12-bit payload of the most recent frame
    uint8_t fresh;              // DSHOT_FRESH_* bits: fields updated by the most recent frame
    bool stopped;               // ESC reported "not turning" (0xFFF) more recently than an eRPM
    uint32_t erpm_ms;           // Per-field receive times (0 = never received)
    uint32_t voltage_ms;
    uint32_t current_ms;
    uint32_t temperature_ms;
} dshot_telemetry_t;

#define DSHOT_FRESH_ERPM  0x01   // eRPM or stopped frame
#define DSHOT_FRESH_VOLT  0x02
#define DSHOT_FRESH_CURR  0x04
#define DSHOT_FRESH_TEMP  0x08
#define DSHOT_FRESH_EVENT 0x10

// AM32 2.20 sends EDT current as amps/2 per step; the EDT spec (and newer
// AM32) use 1 A per step.  Centi-amps per step:
#ifndef DSHOT_EDT_CURRENT_CA_PER_STEP
#define DSHOT_EDT_CURRENT_CA_PER_STEP 50
#endif

// Receive statistics (bidirectional mode).
typedef struct {
    uint32_t frames_sent;          // telemetry-capable frames transmitted
    uint32_t replies_read;         // captures read from the PIO
    uint32_t results[DSHOT_RX_RESULT_COUNT];      // decode outcome counts
    uint32_t kinds[DSHOT_FRAME_KIND_COUNT];       // valid frames by kind
    uint32_t edt_enabled_events;   // 0xE00
    uint32_t edt_disabled_events;  // 0xEFF
    uint32_t discarded_words;      // RX words drained unread before a send
} dshot_rx_stats_t;

// DShot configuration
typedef struct {
    uint8_t gpio_pin;           // GPIO pin for DShot output
    dshot_speed_t speed;        // DShot speed (150/300/600/1200)
    bool bidirectional;         // Enable EDT telemetry
    uint8_t pole_pairs;         // Motor pole pairs (for RPM calculation)
} dshot_config_t;

/**
 * Initialize DShot for a motor channel
 *
 * @param motor Motor channel
 * @param config DShot configuration
 * @return true on success
 */
bool dshot_init(motor_channel_t motor, const dshot_config_t* config);

/**
 * Send DShot throttle command
 *
 * @param motor Motor channel
 * @param throttle Throttle value (0-2047, or 48-2047 for safety)
 * @param request_telemetry Request telemetry response
 * @return true on success
 */
bool dshot_send_throttle(motor_channel_t motor, uint16_t throttle, bool request_telemetry);

/**
 * Override CRC inversion for bidirectional bring-up.
 *
 * @param motor Motor channel
 * @param invert -1 = use config, 0 = normal CRC, 1 = inverted CRC
 */
void dshot_set_crc_invert_override(motor_channel_t motor, int8_t invert);

/**
 * Send DShot special command
 *
 * Must be sent 6+ times with 1ms delay to take effect
 *
 * @param motor Motor channel
 * @param cmd Special command
 * @return true on success
 */
bool dshot_send_command(motor_channel_t motor, dshot_command_t cmd);

/**
 * Read telemetry data (if bidirectional EDT enabled)
 *
 * @param motor Motor channel
 * @param telemetry Output telemetry data
 * @return true if new telemetry available
 */
bool dshot_read_telemetry(motor_channel_t motor, dshot_telemetry_t* telemetry);

/**
 * Read one raw reply capture (DSHOT_RX_WORDS words of line samples) without
 * decoding it.  For diagnostics; normal code uses dshot_read_telemetry().
 */
bool dshot_read_telemetry_raw(motor_channel_t motor, uint32_t words[DSHOT_RX_WORDS]);

/**
 * Receive statistics since init or the last reset.
 */
bool dshot_get_rx_stats(motor_channel_t motor, dshot_rx_stats_t* stats);
void dshot_reset_rx_stats(motor_channel_t motor);

/**
 * Convert electrical RPM to mechanical RPM
 *
 * @param erpm Electrical RPM from telemetry
 * @param pole_pairs Number of motor pole pairs (poles / 2)
 * @return Mechanical RPM
 */
uint32_t dshot_erpm_to_rpm(uint32_t erpm, uint8_t pole_pairs);

/**
 * Get latest telemetry for motor
 *
 * @param motor Motor channel
 * @param telemetry Output telemetry data
 * @return true if telemetry available
 */
bool dshot_get_telemetry(motor_channel_t motor, dshot_telemetry_t* telemetry);

/**
 * True once the ESC has acknowledged EDT enable (0xE00) or sent any EDT frame.
 *
 * @param motor Motor channel
 * @return true if extended telemetry is active
 */
bool dshot_extended_telemetry_active(motor_channel_t motor);

/**
 * Check whether any extended telemetry frame has been decoded.
 *
 * @param motor Motor channel
 * @return true if extended telemetry has been seen
 */
bool dshot_extended_telemetry_seen(motor_channel_t motor);

/**
 * Check whether the DShot state machine is enabled for a motor.
 *
 * @param motor Motor channel
 * @return true if the PIO state machine is enabled
 */
bool dshot_sm_is_enabled(motor_channel_t motor);

/**
 * Read DShot PIO FIFO levels for debugging.
 *
 * @param motor Motor channel
 * @param tx_level Output TX FIFO level (optional)
 * @param rx_level Output RX FIFO level (optional)
 * @return true if motor is initialized
 */
bool dshot_get_fifo_levels(motor_channel_t motor, uint8_t* tx_level, uint8_t* rx_level);

/**
 * Get counts of decoded telemetry frame types for a motor.
 *
 * @param motor Motor channel
 * @param counts Output array of 16 entries (indexed by type nibble)
 */
void dshot_get_telemetry_type_counts(motor_channel_t motor, uint32_t counts[16]);

/**
 * Reset telemetry type counters for a motor.
 *
 * @param motor Motor channel
 */
void dshot_reset_telemetry_type_counts(motor_channel_t motor);

/**
 * Calculate DShot CRC4
 *
 * @param packet 12-bit packet data
 * @return 4-bit CRC
 */
uint8_t dshot_calculate_crc(uint16_t packet);

/**
 * Convert throttle percentage to DShot value
 *
 * @param percent Throttle percentage (-100 to +100)
 * @return DShot throttle value (48-2047, 0 = disarmed)
 */
uint16_t dshot_throttle_from_percent(int8_t percent);

/**
 * Convert throttle percentage to DShot value (unidirectional).
 *
 * @param percent Throttle percentage (0 to 100)
 * @return DShot throttle value (48-2047, 0 = disarmed)
 */
uint16_t dshot_throttle_from_percent_unidir(uint8_t percent);

/**
 * Convert throttle percentage to DShot value for 3D mode (bidirectional spin).
 *
 * DShot 3D mode splits the throttle range:
 *   0          = stop
 *   48-1047    = reverse (48=min, 1047=max)
 *   1048-2047  = forward (1048=min, 2047=max)
 *
 * @param percent Throttle percentage (-100 to +100)
 * @return DShot throttle value (0 = stop, 48-1047 reverse, 1048-2047 forward)
 */
uint16_t dshot_throttle_from_percent_3d(int8_t percent);

/**
 * Deinitialize DShot and free resources
 *
 * Stops the state machine, removes PIO program, and releases DMA channel.
 * Call this before switching back to PWM mode or when shutting down.
 *
 * @param motor Motor channel to deinitialize
 */
void dshot_deinit(motor_channel_t motor);

/**
 * Pause or resume the DShot output.  Paused, the pin is driven low and no
 * frames are sent (dshot_send_throttle returns false).
 *
 * An AM32 ESC decides at power-up whether to run its firmware from the
 * signal line: if it sees the line high throughout its ~10 ms check it stays
 * in the bootloader and ignores DShot until power-cycled.  Idle-high DShot
 * with frames more than ~5 ms apart can look like that, so the line is held
 * low whenever the weapon is disarmed.
 */
void dshot_set_output_paused(motor_channel_t motor, bool paused);
bool dshot_output_paused(motor_channel_t motor);

#endif // DSHOT_H
