stevemance/thumbsup/firmware/src/hitl_console.c

#include "hitl_console.h"

#include <ctype.h>
#include <stdio.h>
#include <stdlib.h>
#include <string.h>

#if HITL_CONSOLE
#include <btstack.h>
#include <uni.h>
#endif

#include "config.h"
#include "drive_hbridge.h"
#include "hitl_overrides.h"
#include "bluetooth_platform.h"
#include "pico/stdlib.h"
#include "system_status.h"
#include "motor_control.h"
#include "dshot.h"
#include "weapon.h"
#include "battery_monitor.h"
#include "hardware/gpio.h"

#define HITL_LINE_MAX 160
#define HITL_STATUS_INTERVAL_MS 100

#if HITL_CONSOLE

static bool controller_connected = false;
static bool controller_ready = false;
static uint32_t last_status_ms = 0;
static uint32_t status_interval_ms = HITL_STATUS_INTERVAL_MS;

// --- Latency tracking state ---
typedef enum {
    LATENCY_IDLE,
    LATENCY_ARMED,           // Waiting for spinup
    LATENCY_TRACKING_UP,     // Tracking spinup events
    LATENCY_TRACKING_DOWN,   // Tracking spindown events
} latency_phase_t;

static latency_phase_t latency_phase = LATENCY_IDLE;
static uint32_t latency_rpm_threshold = 500;

// Spinup timestamps (microseconds, from time_us_64()).
static uint64_t lat_t_ry_nonzero_us = 0;
static uint64_t lat_t_target_set_us = 0;
static uint64_t lat_t_dshot_nonzero_us = 0;
static uint64_t lat_t_rpm_seen_us = 0;
// Spindown timestamps.
static uint64_t lat_t_ry_zero_us = 0;
static uint64_t lat_t_rpm_below_us = 0;

// Track previous RY value to detect 0->nonzero and nonzero->0 edges.
static int32_t lat_prev_ry = 0;

static bool streq_case(const char* a, const char* b) {
    while (*a && *b) {
        if (tolower((unsigned char)*a) != tolower((unsigned char)*b)) {
            return false;
        }
        a++;
        b++;
    }
    return *a == '\0' && *b == '\0';
}

static const char* weapon_state_label(weapon_state_t state) {
    switch (state) {
        case WEAPON_STATE_DISARMED:
            return "DISARMED";
        case WEAPON_STATE_ARMING:
            return "ARMING";
        case WEAPON_STATE_ARMED:
            return "ARMED";
        case WEAPON_STATE_SPINNING:
            return "SPINNING";
        case WEAPON_STATE_EMERGENCY_STOP:
            return "ESTOP";
        default:
            return "UNKNOWN";
    }
}

static const char* weapon_mode_label(weapon_control_mode_t mode) {
    switch (mode) {
        case WEAPON_MODE_PWM:
            return "PWM";
        case WEAPON_MODE_DSHOT:
            return "DSHOT";
        case WEAPON_MODE_CONFIG:
            return "CONFIG";
        default:
            return "UNKNOWN";
    }
}

static void hitl_print_help(void) {
    printf("HITL commands:\n");
    printf("  HITL HELP\n");
    printf("  HITL STATUS\n");
    printf("  HITL STATUSRATE <ms>\n");
    printf("  HITL BTADDR\n");
    printf("  HITL BTKEYS CLEAR\n");
    printf("  HITL BTKEYS LIST\n");
    printf("  HITL AUTOSCAN <0|1>\n");
    printf("  HITL TELEM\n");
    printf("  HITL TELEMSTATS\n");
    printf("  HITL TELEMRATE <ms>\n");
    printf("  HITL BATTERY <mv>\n");
    printf("  HITL BATTERY OFF\n");
    printf("  HITL PWMHZ <50..490>\n");
#if DRIVE_HBRIDGE
    printf("  HITL DRV                       (H-bridge status)\n");
    printf("  HITL DRVACCEL <pct_per_s>      (0 = off)\n");
    printf("  HITL DRVDRAG <0..1000>         (zero-command brake fraction)\n");
    printf("  HITL DRVSET <L|R> <-1000..1000|OFF>\n");
    printf("  HITL DRVPROBE <L|R> <ms>       (coast window for EMF ground truth)\n");
    printf("  HITL DRVTRACE <L|R> [n]        (raw current-sense samples)\n");
    printf("  HITL DRVHEALTH [RESET]         (learned speed gains, health)\n");
    printf("  HITL DRVMATCH <0|1>            (speed matching)\n");
    printf("  HITL DRVDERATE <L|R> <0..1000> (simulate a weak motor)\n");
#endif
    printf("  HITL RXSTATS [RESET]\n");
    printf("  HITL EDTSTATS [RESET]\n");
    printf("  HITL WEAPON <-100..100|OFF>   (armed only; overrides triggers)\n");
    printf("  HITL LATENCY ARM <rpm_threshold>\n");
    printf("  HITL LATENCY DISARM\n");
}

static void hitl_print_btaddr(void) {
    bd_addr_t addr;
    gap_local_bd_addr(addr);
    printf("HITL BTADDR %s\n", bd_addr_to_str(addr));
}

static void hitl_print_telem(void) {
    weapon_telemetry_t telem;
    uint32_t age = weapon_get_telemetry_age_ms();
    if (weapon_get_telemetry(&telem)) {
        printf("TELEM valid=1 age=%lu erpm=%lu rpm=%lu V=%.2f I=%.2f T=%u\n",
               (unsigned long)age,
               (unsigned long)telem.erpm,
               (unsigned long)telem.rpm,
               telem.voltage_cV / 100.0f,
               telem.current_cA / 100.0f,
               telem.temperature_C);
    } else {
        if (age == UINT32_MAX) {
            printf("TELEM valid=0 age=--\n");
        } else {
            printf("TELEM valid=0 age=%lu\n", (unsigned long)age);
        }
    }
}

static void hitl_print_telem_stats(void) {
    uint32_t req = 0;
    uint32_t resp = 0;
    uint32_t rx_raw = 0;
    uint32_t rx_discarded = 0;
    uint32_t dec_frames = 0;
    uint64_t dec_us = 0;
    uint32_t bad = 0;
    uint32_t tx = 0;
    uint32_t tx_ok = 0;
    uint16_t last_thr = 0;
    bool setup_pending = false;
    bool setup_done = false;
    weapon_get_dshot_telemetry_counts(&req, &resp);
    weapon_get_dshot_telemetry_rx_counts(&rx_raw, &rx_discarded);
    weapon_get_dshot_telemetry_debug(NULL, &bad);
    weapon_get_dshot_telemetry_timing(&dec_frames, &dec_us);
    weapon_get_dshot_send_counts(&tx, &tx_ok);
    last_thr = weapon_get_dshot_last_throttle();
    weapon_get_dshot_setup_state(&setup_pending, &setup_done);
    weapon_control_mode_t mode = weapon_get_control_mode();
    uint32_t age = weapon_get_telemetry_age_ms();
    uint32_t reqbit = weapon_get_dshot_telemetry_reqbit_tx();
    uint32_t decode_pct = (dec_frames > 0) ? (resp * 100u) / dec_frames : 0;
    uint32_t decode_us_avg = (dec_frames > 0) ? (uint32_t)(dec_us / dec_frames) : 0;

    if (age == UINT32_MAX) {
        printf("TELEMSTATS mode=%s req=%lu resp=%lu reqbit=%lu rx=%lu disc=%lu dec=%lu bad=%lu ok_pct=%lu dec_us=%lu age=-- tx=%lu ok_tx=%lu thr=%u fail=%lu setup_pend=%u setup_done=%u\n",
               weapon_mode_label(mode),
               (unsigned long)req,
               (unsigned long)resp,
               (unsigned long)reqbit,
               (unsigned long)rx_raw,
               (unsigned long)rx_discarded,
               (unsigned long)dec_frames,
               (unsigned long)bad,
               (unsigned long)decode_pct,
               (unsigned long)decode_us_avg,
               (unsigned long)tx,
               (unsigned long)tx_ok,
               (unsigned)last_thr,
               (unsigned long)weapon_get_dshot_failures(),
               setup_pending ? 1u : 0u,
               setup_done ? 1u : 0u);
    } else {
        printf("TELEMSTATS mode=%s req=%lu resp=%lu reqbit=%lu rx=%lu disc=%lu dec=%lu bad=%lu ok_pct=%lu dec_us=%lu age=%lu tx=%lu ok_tx=%lu thr=%u fail=%lu setup_pend=%u setup_done=%u\n",
               weapon_mode_label(mode),
               (unsigned long)req,
               (unsigned long)resp,
               (unsigned long)reqbit,
               (unsigned long)rx_raw,
               (unsigned long)rx_discarded,
               (unsigned long)dec_frames,
               (unsigned long)bad,
               (unsigned long)decode_pct,
               (unsigned long)decode_us_avg,
               (unsigned long)age,
               (unsigned long)tx,
               (unsigned long)tx_ok,
               (unsigned)last_thr,
               (unsigned long)weapon_get_dshot_failures(),
               setup_pending ? 1u : 0u,
               setup_done ? 1u : 0u);
    }
}

static void hitl_print_status(const uni_gamepad_t* gp) {
    // Guard: skip this status update if the USB serial TX buffer can't fit the
    // whole message.  CFG_TUD_CDC_TX_BUFSIZE is 512 for HITL builds; a status
    // line is ~350 bytes.  If 350+ bytes are available we can write the full
    // line in one non-blocking shot.  If less is free we skip this interval
    // rather than entering printf's blocking tud_task loop (which stalls the
    // btstack event loop and causes missed BT HID reports).
    extern bool stdio_usb_connected(void);
    extern uint32_t tud_cdc_n_write_available(uint8_t itf);
    if (!stdio_usb_connected() || tud_cdc_n_write_available(0) < 350) {
        return;
    }

    uint32_t now_ms = to_ms_since_boot(get_absolute_time());
    uint32_t batt_mv = read_battery_voltage();

    uint16_t dl_us = motor_control_get_pulse(MOTOR_LEFT_DRIVE);
    uint16_t dr_us = motor_control_get_pulse(MOTOR_RIGHT_DRIVE);

    weapon_telemetry_t telem;
    bool telem_ok = weapon_get_telemetry(&telem);
    uint32_t age = weapon_get_telemetry_age_ms();

    // Raw stick/pedal values for debugging (no longer drive the weapon).
    int32_t w_raw_ry = gp ? CLAMP(gp->axis_ry, -512, 511) : 0;
    int32_t w_stick = 0;
    if (abs(w_raw_ry) > TRIGGER_THRESHOLD) {
        if (w_raw_ry > 0) {
            w_stick = ((w_raw_ry - TRIGGER_THRESHOLD) * 100) / (511 - TRIGGER_THRESHOLD);
        } else {
            w_stick = ((w_raw_ry + TRIGGER_THRESHOLD) * 100) / (512 - TRIGGER_THRESHOLD);
        }
        w_stick = CLAMP(w_stick, -100, 100);
    }
    int32_t w_thr = 0;
    int32_t w_brk = 0;
    if (gp) {
        int32_t raw_thr = CLAMP(gp->throttle, 0, 1023);
        int32_t raw_brk = CLAMP(gp->brake, 0, 1023);
        if (raw_thr > TRIGGER_THRESHOLD) {
            w_thr = (raw_thr * 100) / 1023;
            w_thr = CLAMP(w_thr, 0, 100);
        }
        if (raw_brk > TRIGGER_THRESHOLD) {
            w_brk = (raw_brk * 100) / 1023;
            w_brk = CLAMP(w_brk, 0, 100);
        }
    }
    // The weapon is commanded by the triggers (ZR forward, ZL reverse); w_cmd
    // shows the raw trigger request.  The robot's latch (first pressed wins,
    // release required after arming) is reflected in target.
    int32_t w_cmd = 0;
    if (gp) {
        bool fwd = (gp->buttons & BTN_TRIGGER_R) || gp->throttle >= WEAPON_TRIGGER_ANALOG_ON;
        bool rev = (gp->buttons & BTN_TRIGGER_L) || gp->brake >= WEAPON_TRIGGER_ANALOG_ON;
        w_cmd = fwd == rev ? 0 : (fwd ? WEAPON_TRIGGER_SPEED : -WEAPON_TRIGGER_SPEED);
    }

    printf("HITL STATUS t_ms=%lu conn=%u ready=%u armed=%u failsafe=%u batt_mv=%lu esc_batt_mv=%lu batt_level=%s weapon=%s speed=%d target=%d thr=%u mode=%s "
           "x=%d y=%d rx=%d ry=%d p_brk=%ld p_thr=%ld w_stick=%ld w_thr=%ld w_brk=%ld w_cmd=%ld buttons=0x%04x dpad=0x%02x dl_us=%u dr_us=%u telem=%u age_ms=",
           (unsigned long)now_ms,
           controller_connected ? 1u : 0u,
           controller_ready ? 1u : 0u,
           system_is_armed() ? 1u : 0u,
            system_failsafe_active() ? 1u : 0u,
            (unsigned long)batt_mv,
            (unsigned long)battery_monitor_mv(),
            battery_monitor_level_name(battery_monitor_level()),
            weapon_state_label(weapon_get_state()),
            weapon_get_speed(),
            weapon_get_target_speed(),
            (unsigned)weapon_get_dshot_last_throttle(),
            weapon_mode_label(weapon_get_control_mode()),
            gp ? (int)gp->axis_x : 0,
            gp ? (int)gp->axis_y : 0,
            gp ? (int)gp->axis_rx : 0,
            gp ? (int)gp->axis_ry : 0,
            gp ? (long)gp->brake : 0,
            gp ? (long)gp->throttle : 0,
            (long)w_stick,
            (long)w_thr,
            (long)w_brk,
            (long)w_cmd,
            gp ? (unsigned)gp->buttons : 0u,
            gp ? (unsigned)gp->dpad : 0u,
            (unsigned)dl_us,
            (unsigned)dr_us,
            telem_ok ? 1u : 0u);

    if (age == UINT32_MAX) {
        printf("--");
    } else {
        printf("%lu", (unsigned long)age);
    }

    if (telem_ok) {
        printf(" rpm=%lu erpm=%lu v=%.2f i=%.2f temp=%u\n",
               (unsigned long)telem.rpm,
               (unsigned long)telem.erpm,
               telem.voltage_cV / 100.0f,
               telem.current_cA / 100.0f,
               telem.temperature_C);
    } else {
        printf("\n");
    }
}

static void hitl_handle_command(const char* line, const uni_gamepad_t* last_gp) {
    char copy[HITL_LINE_MAX];
    strncpy(copy, line, sizeof(copy));
    copy[sizeof(copy) - 1] = '\0';

    char* save = NULL;
    char* tok = strtok_r(copy, " \t", &save);
    if (!tok) {
        return;
    }

    if (!streq_case(tok, "HITL")) {
        return;
    }

    char* cmd = strtok_r(NULL, " \t", &save);
    if (!cmd) {
        hitl_print_help();
        return;
    }

    if (streq_case(cmd, "HELP")) {
        hitl_print_help();
        return;
    }

    if (streq_case(cmd, "STATUS")) {
        hitl_print_status(last_gp);
        return;
    }

    if (streq_case(cmd, "STATUSRATE")) {
        char* value = strtok_r(NULL, " \t", &save);
        if (!value) {
            printf("ERR HITL STATUSRATE expects <ms>\n");
            return;
        }
        char* end = NULL;
        unsigned long ms = strtoul(value, &end, 0);
        if (!end || *end != '\0') {
            printf("ERR HITL STATUSRATE invalid: %s\n", value);
            return;
        }
        if (ms < 5) {
            ms = 5;
        }
        if (ms > 2000) {
            ms = 2000;
        }
        status_interval_ms = (uint32_t)ms;
        printf("HITL STATUSRATE ms=%lu\n", ms);
        return;
    }

    if (streq_case(cmd, "BTADDR")) {
        hitl_print_btaddr();
        return;
    }

    if (streq_case(cmd, "BTKEYS")) {
        char* sub = strtok_r(NULL, " \t", &save);
        if (!sub) {
            printf("ERR HITL BTKEYS expects <CLEAR|LIST>\n");
            return;
        }
        if (streq_case(sub, "CLEAR")) {
            uni_bt_del_keys_unsafe();
            printf("HITL BTKEYS cleared\n");
            return;
        }
        if (streq_case(sub, "LIST")) {
            uni_bt_list_keys_unsafe();
            printf("HITL BTKEYS listed\n");
            return;
        }
        printf("ERR HITL BTKEYS unknown: %s\n", sub);
        return;
    }

    if (streq_case(cmd, "AUTOSCAN")) {
        char* sub = strtok_r(NULL, " \t", &save);
        if (!sub) {
            printf("HITL AUTOSCAN %u\n", bluetooth_platform_get_autoscan() ? 1u : 0u);
            return;
        }
        if (streq_case(sub, "1") || streq_case(sub, "ON")) {
            bluetooth_platform_set_autoscan(true);
            printf("HITL AUTOSCAN 1\n");
            return;
        }
        if (streq_case(sub, "0") || streq_case(sub, "OFF")) {
            bluetooth_platform_set_autoscan(false);
            printf("HITL AUTOSCAN 0\n");
            return;
        }
        printf("ERR HITL AUTOSCAN expects <0|1>\n");
        return;
    }

    if (streq_case(cmd, "TELEM")) {
        hitl_print_telem();
        return;
    }

    if (streq_case(cmd, "TELEMSTATS")) {
        hitl_print_telem_stats();
        return;
    }

    if (streq_case(cmd, "TELEMRATE")) {
        char* value = strtok_r(NULL, " \t", &save);
        if (!value) {
            printf("ERR HITL TELEMRATE expects <ms>\n");
            return;
        }
        char* end = NULL;
        unsigned long ms = strtoul(value, &end, 0);
        if (!end || *end != '\0') {
            printf("ERR HITL TELEMRATE invalid: %s\n", value);
            return;
        }
        if (ms < 2) {
            ms = 2;
        }
        if (ms > 500) {
            ms = 500;
        }
        weapon_set_telemetry_interval_ms((uint32_t)ms);
        printf("HITL TELEMRATE ms=%lu\n", ms);
        return;
    }

    if (streq_case(cmd, "LATENCY")) {
        char* sub = strtok_r(NULL, " \t", &save);
        if (!sub) {
            printf("ERR HITL LATENCY expects ARM <rpm_threshold> or DISARM\n");
            return;
        }
        if (streq_case(sub, "ARM")) {
            char* thr_str = strtok_r(NULL, " \t", &save);
            if (!thr_str) {
                printf("ERR HITL LATENCY ARM expects <rpm_threshold>\n");
                return;
            }
            char* end = NULL;
            unsigned long thr = strtoul(thr_str, &end, 0);
            if (!end || *end != '\0') {
                printf("ERR HITL LATENCY ARM invalid: %s\n", thr_str);
                return;
            }
            latency_rpm_threshold = (uint32_t)thr;
            latency_phase = LATENCY_ARMED;
            lat_t_ry_nonzero_us = 0;
            lat_t_target_set_us = 0;
            lat_t_dshot_nonzero_us = 0;
            lat_t_rpm_seen_us = 0;
            lat_t_ry_zero_us = 0;
            lat_t_rpm_below_us = 0;
            lat_prev_ry = 0;
            printf("HITL LATENCY ARMED rpm_threshold=%lu\n", (unsigned long)latency_rpm_threshold);
            return;
        }
        if (streq_case(sub, "DISARM")) {
            latency_phase = LATENCY_IDLE;
            printf("HITL LATENCY DISARMED\n");
            return;
        }
        printf("ERR HITL LATENCY unknown: %s\n", sub);
        return;
    }

    if (streq_case(cmd, "BATTERY")) {
        char* value = strtok_r(NULL, " \t", &save);
        if (!value) {
            printf("ERR HITL BATTERY expects <mv|OFF>\n");
            return;
        }
        if (streq_case(value, "OFF")) {
            hitl_overrides_clear_battery_mv();
            printf("HITL BATTERY off\n");
            return;
        }
        char* end = NULL;
        unsigned long mv = strtoul(value, &end, 0);
        if (!end || *end != '\0') {
            printf("ERR HITL BATTERY invalid: %s\n", value);
            return;
        }
        hitl_overrides_set_battery_mv((uint32_t)mv);
        printf("HITL BATTERY mv=%lu\n", mv);
        return;
    }

    if (streq_case(cmd, "WPNLINE")) {
        // Sets the idle level of the weapon signal pin while disarmed, to
        // test how the ESC bootloader reacts to it at power-up.
        char* value = strtok_r(NULL, " \t", &save);
        if (weapon_is_armed() || !value) {
            printf("ERR HITL WPNLINE expects HIGH|LOW|PULLUP while disarmed\n");
            return;
        }
        gpio_set_function(PIN_WEAPON_PWM, GPIO_FUNC_SIO);
        if (streq_case(value, "PULLUP")) {
            gpio_set_dir(PIN_WEAPON_PWM, GPIO_IN);
            gpio_pull_up(PIN_WEAPON_PWM);
        } else {
            gpio_set_dir(PIN_WEAPON_PWM, GPIO_OUT);
            gpio_put(PIN_WEAPON_PWM, streq_case(value, "HIGH") ? 1 : 0);
        }
        printf("HITL WPNLINE %s\n", value);
        return;
    }

    if (streq_case(cmd, "WEAPON")) {
        char* value = strtok_r(NULL, " \t", &save);
        if (value && streq_case(value, "OFF")) {
            hitl_overrides_clear_weapon_pct();
            if (weapon_is_armed()) {
                weapon_set_speed(0);
            }
            printf("HITL WEAPON off\n");
            return;
        }
        long pct = value ? strtol(value, NULL, 0) : 0;
        if (!value || pct < -100 || pct > 100) {
            printf("ERR HITL WEAPON expects -100..100|OFF\n");
            return;
        }
        hitl_overrides_set_weapon_pct((int8_t)pct);
        if (weapon_is_armed()) {
            weapon_set_speed((int8_t)pct);
        }
        printf("HITL WEAPON pct=%ld armed=%u\n", pct, weapon_is_armed() ? 1u : 0u);
        return;
    }

    if (streq_case(cmd, "EDTSTATS")) {
        char* arg = strtok_r(NULL, " \t", &save);
        dshot_rx_stats_t st;
        if (!dshot_get_rx_stats(MOTOR_WEAPON, &st)) {
            printf("ERR HITL EDTSTATS dshot not initialized\n");
            return;
        }
        weapon_telemetry_t wt = {0};
        weapon_get_telemetry_snapshot(&wt);
        uint32_t now = to_ms_since_boot(get_absolute_time());
#define AGE(ms) ((ms) ? (long)(now - (ms)) : -1L)
        // Raw ESC current as sent (ignored by the weapon logic while
        // WEAPON_ESC_HAS_CURRENT_SENSE is 0), for current-sensor checks.
        dshot_telemetry_t raw_t = {0};
        bool raw_ok = dshot_get_telemetry(MOTOR_WEAPON, &raw_t);
        printf("HITL EDTSTATS sent=%lu read=%lu ok=%lu no_start=%lu bitcount=%lu gcr=%lu crc=%lu "
               "erpm=%lu stopped=%lu temp=%lu volt=%lu curr=%lu dbg=%lu stress=%lu event=%lu "
               "e00=%lu eff=%lu discarded_words=%lu edt_active=%u "
               "rpm=%lu rpm_age=%ld v=%.2f v_age=%ld t=%u t_age=%ld i_age=%ld i_raw_ca=%u i_raw_age=%ld esc_recoveries=%lu\n",
               (unsigned long)st.frames_sent, (unsigned long)st.replies_read,
               (unsigned long)st.results[DSHOT_RX_OK], (unsigned long)st.results[DSHOT_RX_NO_START],
               (unsigned long)st.results[DSHOT_RX_BITCOUNT], (unsigned long)st.results[DSHOT_RX_GCR],
               (unsigned long)st.results[DSHOT_RX_CRC],
               (unsigned long)st.kinds[DSHOT_FRAME_ERPM], (unsigned long)st.kinds[DSHOT_FRAME_STOPPED],
               (unsigned long)st.kinds[DSHOT_FRAME_TEMP], (unsigned long)st.kinds[DSHOT_FRAME_VOLT],
               (unsigned long)st.kinds[DSHOT_FRAME_CURR],
               (unsigned long)(st.kinds[DSHOT_FRAME_DEBUG1] + st.kinds[DSHOT_FRAME_DEBUG2]),
               (unsigned long)st.kinds[DSHOT_FRAME_STRESS], (unsigned long)st.kinds[DSHOT_FRAME_EVENT],
               (unsigned long)st.edt_enabled_events, (unsigned long)st.edt_disabled_events,
               (unsigned long)st.discarded_words,
               dshot_extended_telemetry_active(MOTOR_WEAPON) ? 1u : 0u,
               (unsigned long)wt.rpm, AGE(wt.erpm_ms), wt.voltage_cV / 100.0f, AGE(wt.voltage_ms),
               wt.temperature_C, AGE(wt.temperature_ms), AGE(wt.current_ms),
               raw_ok ? raw_t.current_cA : 0u, raw_ok ? AGE(raw_t.current_ms) : -1L,
               (unsigned long)weapon_get_esc_recoveries());
#undef AGE
        if (arg && streq_case(arg, "RESET")) {
            dshot_reset_rx_stats(MOTOR_WEAPON);
        }
        return;
    }

    if (streq_case(cmd, "RXSTATS")) {
        char* arg = strtok_r(NULL, " \t", &save);
        bluetooth_platform_print_rx_stats(arg && streq_case(arg, "RESET"));
        return;
    }

#if DRIVE_HBRIDGE
    if (streq_case(cmd, "DRV")) {
        drive_hb_status_t st;
        drive_hb_get_status(&st);
        printf("HITL DRV awake=%u fault=%u fault_events=%lu batt_mv=%lu accel=%u drag=%u match=%u "
               "degraded_events=%lu",
               st.awake ? 1u : 0u, st.fault ? 1u : 0u, (unsigned long)st.fault_events,
               (unsigned long)st.battery_mv, st.accel_limit_pct_s, st.drag_brake_permille,
               st.match_enabled ? 1u : 0u, (unsigned long)st.degraded_events);
        for (int i = 0; i < 2; i++) {
            const drive_hb_motor_t* m = &st.motor[i];
            const char* n = i == 0 ? "l" : "r";
            printf(" %s_tgt=%d %s_app=%d %s_ma=%u %s_emf_mv=%ld %s_rpm=%ld %s_valid=%u "
                   "%s_r_mohm=%lu %s_rcal_n=%lu %s_rrun_n=%lu %s_ovr=%u %s_scale=%u %s_health=%u %s_degraded=%u "
                   "%s_rough=%u %s_derate=%u",
                   n, m->target_permille, n, m->applied_permille, n, m->current_ma,
                   n, (long)m->emf_mv, n, (long)m->wheel_rpm, n, m->emf_valid ? 1u : 0u,
                   n, (unsigned long)m->resistance_mohm, n, (unsigned long)m->resistance_samples,
                   n, (unsigned long)m->resistance_run_samples,
                   n, m->overridden ? 1u : 0u, n, m->match_scale_permille, n, m->health_permille,
                   n, m->degraded ? 1u : 0u, n, m->roughness_permille, n, m->derate_permille);
        }
        printf("\n");
        return;
    }

    if (streq_case(cmd, "DRVACCEL") || streq_case(cmd, "DRVDRAG")) {
        char* value = strtok_r(NULL, " \t", &save);
        long v = value ? strtol(value, NULL, 0) : -1;
        bool accel = streq_case(cmd, "DRVACCEL");
        if (v < 0 || v > (accel ? 60000 : 1000)) {
            printf("ERR HITL %s bad value\n", cmd);
            return;
        }
        if (accel) {
            drive_hb_set_accel_limit((uint16_t)v);
        } else {
            drive_hb_set_drag_brake((uint16_t)v);
        }
        printf("HITL %s %ld\n", accel ? "DRVACCEL" : "DRVDRAG", v);
        return;
    }

    if (streq_case(cmd, "DRVHEALTH")) {
        char* arg = strtok_r(NULL, " \t", &save);
        if (arg && streq_case(arg, "RESET")) {
            drive_hb_reset_learning();
        }
        drive_hb_print_learning();
        return;
    }

    if (streq_case(cmd, "DRVMATCH")) {
        char* value = strtok_r(NULL, " \t", &save);
        if (!value || (strcmp(value, "0") && strcmp(value, "1"))) {
            printf("ERR HITL DRVMATCH expects 0|1\n");
            return;
        }
        drive_hb_set_match(value[0] == '1');
        printf("HITL DRVMATCH %s\n", value);
        return;
    }

    if (streq_case(cmd, "DRVDERATE")) {
        char* side = strtok_r(NULL, " \t", &save);
        char* value = strtok_r(NULL, " \t", &save);
        long v = value ? strtol(value, NULL, 0) : -1;
        if (!side || (!streq_case(side, "L") && !streq_case(side, "R")) || v < 0 || v > 1000) {
            printf("ERR HITL DRVDERATE expects L|R 0..1000\n");
            return;
        }
        drive_hb_set_derate(streq_case(side, "L") ? MOTOR_LEFT_DRIVE : MOTOR_RIGHT_DRIVE, (uint16_t)v);
        printf("HITL DRVDERATE %s %ld\n", side, v);
        return;
    }

    if (streq_case(cmd, "DRVTRACE")) {
        char* side = strtok_r(NULL, " \t", &save);
        char* value = strtok_r(NULL, " \t", &save);
        if (!side || (!streq_case(side, "L") && !streq_case(side, "R"))) {
            printf("ERR HITL DRVTRACE expects L|R\n");
            return;
        }
        drive_hb_dump_current(streq_case(side, "L") ? MOTOR_LEFT_DRIVE : MOTOR_RIGHT_DRIVE,
                              value ? (uint32_t)strtoul(value, NULL, 0) : 0);
        return;
    }

    if (streq_case(cmd, "DRVSET") || streq_case(cmd, "DRVPROBE")) {
        char* side = strtok_r(NULL, " \t", &save);
        char* value = strtok_r(NULL, " \t", &save);
        motor_channel_t m;
        if (side && streq_case(side, "L")) {
            m = MOTOR_LEFT_DRIVE;
        } else if (side && streq_case(side, "R")) {
            m = MOTOR_RIGHT_DRIVE;
        } else {
            printf("ERR HITL %s expects L|R\n", cmd);
            return;
        }
        if (!value) {
            printf("ERR HITL %s missing value\n", cmd);
            return;
        }
        if (streq_case(cmd, "DRVPROBE")) {
            long ms = strtol(value, NULL, 0);
            if (ms < 1 || ms > 1000 || !drive_hb_probe(m, (uint16_t)ms)) {
                printf("ERR HITL DRVPROBE failed\n");
            }
            return;
        }
        if (streq_case(value, "OFF")) {
            drive_hb_set_override(m, false, 0);
            printf("HITL DRVSET %s OFF\n", side);
            return;
        }
        long d = strtol(value, NULL, 0);
        if (d < -1000 || d > 1000) {
            printf("ERR HITL DRVSET expects -1000..1000|OFF\n");
            return;
        }
        drive_hb_set_override(m, true, (int16_t)d);
        printf("HITL DRVSET %s %ld\n", side, d);
        return;
    }
#endif

    if (streq_case(cmd, "PWMHZ")) {
        char* value = strtok_r(NULL, " \t", &save);
        unsigned long hz = value ? strtoul(value, NULL, 0) : 0;
        if (!motor_control_set_drive_frame_rate((uint32_t)hz)) {
            printf("ERR HITL PWMHZ expects 50..490\n");
            return;
        }
        printf("HITL PWMHZ hz=%lu\n", hz);
        return;
    }

    printf("ERR unknown HITL command: %s\n", cmd);
}

static void hitl_poll_serial(const uni_gamepad_t* last_gp) {
    static char line[HITL_LINE_MAX];
    static size_t len = 0;

    int ch = getchar_timeout_us(0);
    while (ch != PICO_ERROR_TIMEOUT) {
        if (ch == '\r' || ch == '\n') {
            if (len > 0) {
                line[len] = '\0';
                hitl_handle_command(line, last_gp);
                len = 0;
            }
        } else if (len + 1 < sizeof(line)) {
            line[len++] = (char)ch;
        } else {
            len = 0;
        }
        ch = getchar_timeout_us(0);
    }
}

void hitl_console_init(void) {
    hitl_overrides_init();
    controller_connected = false;
    controller_ready = false;
    last_status_ms = 0;
    status_interval_ms = HITL_STATUS_INTERVAL_MS;
    printf("HITL console enabled\n");
    hitl_print_help();
}

void hitl_console_set_controller_connected(bool connected) {
    controller_connected = connected;
    printf("HITL EVENT controller_connected=%u\n", connected ? 1u : 0u);
}

void hitl_console_set_controller_ready(bool ready) {
    controller_ready = ready;
    printf("HITL EVENT controller_ready=%u\n", ready ? 1u : 0u);
}

void hitl_console_on_gamepad(const uni_gamepad_t* gp) {
    uint32_t now_ms = to_ms_since_boot(get_absolute_time());
    hitl_poll_serial(gp);
    if (last_status_ms == 0 || (now_ms - last_status_ms) >= status_interval_ms) {
        hitl_print_status(gp);
        last_status_ms = now_ms;
    }
}

// --- Latency callback implementations ---

void hitl_latency_on_ry_change(int32_t ry) {
    if (latency_phase == LATENCY_ARMED && lat_prev_ry == 0 && ry != 0) {
        // 0 -> nonzero: start spinup tracking.
        latency_phase = LATENCY_TRACKING_UP;
        lat_t_ry_nonzero_us = time_us_64();
        lat_t_target_set_us = 0;
        lat_t_dshot_nonzero_us = 0;
        lat_t_rpm_seen_us = 0;
        printf("HITL LATENCY EVENT ry_nonzero t_us=%llu ry=%ld\n",
               (unsigned long long)lat_t_ry_nonzero_us, (long)ry);
    } else if (latency_phase == LATENCY_TRACKING_DOWN && lat_prev_ry != 0 && ry == 0) {
        // nonzero -> 0 during spindown tracking: nothing extra needed, we already
        // recorded ry_zero when transitioning to TRACKING_DOWN. But if the caller
        // sends repeated zero commands, just skip.
    } else if (latency_phase == LATENCY_TRACKING_UP && lat_t_ry_nonzero_us != 0 &&
               lat_t_rpm_seen_us != 0 && ry == 0) {
        // Spindown edge while we are still in TRACKING_UP but already got RESULT.
        // This shouldn't normally happen because TRACKING_UP transitions to
        // TRACKING_DOWN after RESULT, but handle gracefully.
    }
    lat_prev_ry = ry;
}

void hitl_latency_on_target_set(uint8_t target) {
    if (latency_phase == LATENCY_TRACKING_UP && lat_t_target_set_us == 0 && target > 0) {
        lat_t_target_set_us = time_us_64();
        printf("HITL LATENCY EVENT target_set t_us=%llu target=%u\n",
               (unsigned long long)lat_t_target_set_us, (unsigned)target);
    }
}

void hitl_latency_on_dshot_sent(uint16_t throttle) {
    if (latency_phase == LATENCY_TRACKING_UP && lat_t_dshot_nonzero_us == 0 && throttle > 0) {
        lat_t_dshot_nonzero_us = time_us_64();
        printf("HITL LATENCY EVENT dshot_nonzero t_us=%llu thr=%u\n",
               (unsigned long long)lat_t_dshot_nonzero_us, (unsigned)throttle);
    }
}

void hitl_latency_on_rpm_update(uint32_t rpm) {
    if (latency_phase == LATENCY_TRACKING_UP && lat_t_rpm_seen_us == 0 &&
        rpm >= latency_rpm_threshold) {
        lat_t_rpm_seen_us = time_us_64();
        printf("HITL LATENCY EVENT rpm_seen t_us=%llu rpm=%lu\n",
               (unsigned long long)lat_t_rpm_seen_us, (unsigned long)rpm);

        // Emit spinup summary.
        uint64_t ry = lat_t_ry_nonzero_us;
        uint64_t tgt = lat_t_target_set_us;
        uint64_t dsh = lat_t_dshot_nonzero_us;
        uint64_t rp = lat_t_rpm_seen_us;
        printf("HITL LATENCY RESULT ry_us=%llu target_us=%llu dshot_us=%llu rpm_us=%llu "
               "ry_to_target_us=%llu target_to_dshot_us=%llu dshot_to_rpm_us=%llu total_us=%llu\n",
               (unsigned long long)ry,
               (unsigned long long)tgt,
               (unsigned long long)dsh,
               (unsigned long long)rp,
               (unsigned long long)(tgt > ry ? tgt - ry : 0),
               (unsigned long long)(dsh > tgt ? dsh - tgt : 0),
               (unsigned long long)(rp > dsh ? rp - dsh : 0),
               (unsigned long long)(rp > ry ? rp - ry : 0));

        // Transition to spindown tracking.
        latency_phase = LATENCY_TRACKING_DOWN;
        lat_t_ry_zero_us = 0;
        lat_t_rpm_below_us = 0;
        // Record the zero edge for spindown if RY is already 0.
        if (lat_prev_ry == 0) {
            lat_t_ry_zero_us = time_us_64();
            printf("HITL LATENCY EVENT ry_zero t_us=%llu\n",
                   (unsigned long long)lat_t_ry_zero_us);
        }
    } else if (latency_phase == LATENCY_TRACKING_DOWN) {
        // Track spindown: detect when RY goes to zero.
        if (lat_t_ry_zero_us == 0 && lat_prev_ry == 0) {
            lat_t_ry_zero_us = time_us_64();
            printf("HITL LATENCY EVENT ry_zero t_us=%llu\n",
                   (unsigned long long)lat_t_ry_zero_us);
        }
        // Detect RPM falling below threshold.
        if (lat_t_rpm_below_us == 0 && lat_t_ry_zero_us != 0 && rpm < latency_rpm_threshold) {
            lat_t_rpm_below_us = time_us_64();
            printf("HITL LATENCY EVENT rpm_below t_us=%llu rpm=%lu\n",
                   (unsigned long long)lat_t_rpm_below_us, (unsigned long)rpm);

            // Emit spindown summary.
            printf("HITL LATENCY DOWN ry_us=%llu rpm_us=%llu total_us=%llu\n",
                   (unsigned long long)lat_t_ry_zero_us,
                   (unsigned long long)lat_t_rpm_below_us,
                   (unsigned long long)(lat_t_rpm_below_us > lat_t_ry_zero_us ?
                                        lat_t_rpm_below_us - lat_t_ry_zero_us : 0));

            // Return to ARMED state, ready for the next cycle.
            latency_phase = LATENCY_ARMED;
        }
    }
}

#else

void hitl_console_init(void) {}
void hitl_console_set_controller_connected(bool connected) { (void)connected; }
void hitl_console_set_controller_ready(bool ready) { (void)ready; }
void hitl_console_on_gamepad(const uni_gamepad_t* gp) { (void)gp; }
void hitl_latency_on_ry_change(int32_t ry) { (void)ry; }
void hitl_latency_on_target_set(uint8_t target) { (void)target; }
void hitl_latency_on_dshot_sent(uint16_t throttle) { (void)throttle; }
void hitl_latency_on_rpm_update(uint32_t rpm) { (void)rpm; }

#endif
