stevemance/thumbsup/firmware/include/weapon.h

#ifndef WEAPON_H
#define WEAPON_H

#include <stdint.h>
#include <stdbool.h>

typedef enum {
    WEAPON_STATE_DISARMED,
    WEAPON_STATE_ARMING,
    WEAPON_STATE_ARMED,
    WEAPON_STATE_SPINNING,
    WEAPON_STATE_EMERGENCY_STOP
} weapon_state_t;

// Control mode for weapon (PWM, DShot, or AM32 Config)
typedef enum {
    WEAPON_MODE_PWM,      // Standard PWM control
    WEAPON_MODE_DSHOT,    // DShot digital protocol
    WEAPON_MODE_CONFIG    // AM32 configuration mode (UART)
} weapon_control_mode_t;

typedef struct {
    uint32_t erpm;           // Electrical RPM from ESC telemetry
    uint32_t rpm;            // Mechanical RPM (ERPM / pole pairs)
    uint16_t voltage_cV;     // Voltage in centi-volts
    uint16_t current_cA;     // Current in centi-amps
    uint8_t temperature_C;   // Temperature in Celsius
    uint8_t crc;             // CRC from ESC telemetry
    bool valid;              // True if telemetry is valid
    uint32_t timestamp_ms;   // When the RPM (eRPM or stopped frame) was received
    uint32_t erpm_ms;        // Per-field receive times; 0 = not received since arming
    uint32_t voltage_ms;
    uint32_t current_ms;     // stays 0 when WEAPON_ESC_HAS_CURRENT_SENSE is 0
    uint32_t temperature_ms;
} weapon_telemetry_t;

// Core weapon control functions
bool weapon_init(void);
void weapon_update(void);
bool weapon_arm(void);
bool weapon_disarm(void);
bool weapon_set_speed(int8_t speed_percent);
weapon_state_t weapon_get_state(void);
int8_t weapon_get_speed(void);
int8_t weapon_get_target_speed(void);
bool weapon_is_armed(void);
void weapon_emergency_stop(void);
bool weapon_get_telemetry(weapon_telemetry_t* telemetry);
// Latest per-field values and receive times, regardless of age.
bool weapon_get_telemetry_snapshot(weapon_telemetry_t* telemetry);
// Times the weapon ESC stopped answering while armed and was recovered.
uint32_t weapon_get_esc_recoveries(void);
uint32_t weapon_get_dshot_failures(void);
uint16_t weapon_get_dshot_last_throttle(void);
void weapon_get_dshot_send_counts(uint32_t* attempts, uint32_t* successes);
void weapon_get_dshot_telemetry_counts(uint32_t* requests, uint32_t* responses);
uint32_t weapon_get_dshot_telemetry_reqbit_tx(void);
void weapon_get_dshot_telemetry_rx_counts(uint32_t* raw, uint32_t* discarded);
void weapon_reset_dshot_telemetry_counts(void);
uint32_t weapon_get_telemetry_age_ms(void);
void weapon_get_dshot_telemetry_debug(uint32_t* raw, uint32_t* decode_fail);
void weapon_get_dshot_telemetry_timing(uint32_t* frames, uint64_t* total_us);
void weapon_set_dshot_raw_dump(uint16_t count);
void weapon_get_dshot_setup_state(bool* pending, bool* done);

// Mode switching functions (Critical Fix #2 & #6)
bool weapon_enable_dshot(void);
bool weapon_enable_pwm(void);
bool weapon_enter_config_mode(void);
weapon_control_mode_t weapon_get_control_mode(void);

// Runtime telemetry decode interval (clamped [2, 500] ms).
// Defaults to WEAPON_DSHOT_TELEMETRY_MS from config.h.
void weapon_set_telemetry_interval_ms(uint32_t ms);

#endif // WEAPON_H
