stevemance/thumbsup/tools/hitl_orchestrator.py

#!/usr/bin/env python3
"""
ThumbsUp HITL orchestrator.

Goals:
- Build + flash the HITL robot firmware (Bluetooth competition path + HITL console)
- Build + flash the HITL gamepad emulator firmware
- Run an automated test suite with pass/fail and artifacts

The orchestrator prefers stable udev symlinks:
  - /dev/ttyHITL_ROBOT
  - /dev/ttyHITL_GAMEPAD
"""

from __future__ import annotations

import argparse
import json
import os
import re
import statistics
import subprocess
import sys
import time
from binascii import hexlify
from dataclasses import dataclass
from datetime import datetime
from pathlib import Path

try:
    import serial
    import serial.tools.list_ports
except ImportError as exc:
    print(f"Missing pyserial: {exc}")
    sys.exit(1)

from common import HITL_STATUS_RE, parse_kv_payload, run_cmd, slugify

HITL_EVENT_RE = re.compile(r"^HITL EVENT (.+)$")
HITL_BTADDR_RE = re.compile(r"^HITL BTADDR ([0-9A-Fa-f:]{17})$")
LSUSB_RP2_BOOT_RE = re.compile(r"^Bus\s+(\d+)\s+Device\s+(\d+):\s+ID\s+2e8a:0003\b")


def lsusb_rp2_bootsel_devices() -> set[tuple[int, int]]:
    """Return {(bus, address)} for all connected RP2 BOOTSEL devices (2e8a:0003)."""
    result = run_cmd(["lsusb"], check=True, capture_output=True)
    out: set[tuple[int, int]] = set()
    for line in (result.stdout or "").splitlines():
        m = LSUSB_RP2_BOOT_RE.match(line.strip())
        if not m:
            continue
        out.add((int(m.group(1)), int(m.group(2))))
    return out


def wait_for_new_rp2_bootsel_device(before: set[tuple[int, int]], timeout_s: float) -> tuple[int, int]:
    deadline = time.time() + timeout_s
    while time.time() < deadline:
        now = lsusb_rp2_bootsel_devices()
        new = now - before
        if len(new) == 1:
            return next(iter(new))
        time.sleep(0.05)
    raise RuntimeError("timeout waiting for RP2 BOOTSEL device to appear")


def udev_props(dev: str) -> dict[str, str]:
    result = run_cmd(["udevadm", "info", "-q", "property", "-n", dev], check=True, capture_output=True)
    props: dict[str, str] = {}
    for line in (result.stdout or "").splitlines():
        if "=" not in line:
            continue
        k, v = line.split("=", 1)
        props[k.strip()] = v.strip()
    return props


def find_port_by_symlink(path: str) -> str | None:
    p = Path(path)
    if p.exists():
        return str(p)
    return None


def find_port_by_product(product_hint: str) -> str | None:
    hint = product_hint.lower()
    for port in serial.tools.list_ports.comports():
        product = (port.product or "").lower()
        description = (port.description or "").lower()
        if hint in product or hint in description:
            return port.device
    return None


def resolve_robot_port(timeout_s: float = 10.0) -> str:
    deadline = time.time() + max(0.1, float(timeout_s))
    while time.time() < deadline:
        port = find_port_by_symlink("/dev/ttyHITL_ROBOT")
        if port:
            return port
        port = find_port_by_product("ThumbsUp HITL Robot")
        if port:
            return port
        time.sleep(0.1)
    raise RuntimeError("could not find robot serial port (expected /dev/ttyHITL_ROBOT or USB product match)")


def resolve_gamepad_port(timeout_s: float = 10.0) -> str:
    deadline = time.time() + max(0.1, float(timeout_s))
    while time.time() < deadline:
        port = find_port_by_symlink("/dev/ttyHITL_GAMEPAD")
        if port:
            return port
        port = find_port_by_product("ThumbsUp HITL Gamepad")
        if port:
            return port
        time.sleep(0.1)
    raise RuntimeError("could not find gamepad serial port (expected /dev/ttyHITL_GAMEPAD or USB product match)")


def get_usb_serial_for_tty(dev: str) -> str:
    props = udev_props(dev)
    serial_short = props.get("ID_SERIAL_SHORT")
    if not serial_short:
        raise RuntimeError(f"could not read ID_SERIAL_SHORT for {dev}")
    return serial_short


def wait_for_path(path: str, timeout_s: float) -> None:
    deadline = time.time() + timeout_s
    while time.time() < deadline:
        if Path(path).exists():
            return
        time.sleep(0.1)
    raise RuntimeError(f"timeout waiting for {path}")


def wait_for_tty_ready(path: str, timeout_s: float) -> None:
    wait_for_path(path, timeout_s)
    deadline = time.time() + timeout_s
    while time.time() < deadline:
        try:
            with serial.Serial(path, 115200, timeout=0.05, write_timeout=0.2):
                return
        except serial.SerialException:
            time.sleep(0.1)
    raise RuntimeError(f"timeout waiting for serial port to open: {path}")


def wait_for_tty_reenumerate(path: str, timeout_s: float) -> None:
    # picotool "force reboot" can return before the host tty fully cycles.
    # Wait for the port to disappear at least once (if it does), then wait until it is openable.
    deadline = time.time() + timeout_s
    while time.time() < deadline:
        if not Path(path).exists():
            break
        time.sleep(0.05)
    remaining = max(0.1, deadline - time.time())
    wait_for_tty_ready(path, remaining)


def picotool_flash_via_reset(usb_serial: str, uf2_path: str, *, log_path: Path | None = None) -> None:
    if not Path(uf2_path).exists():
        raise RuntimeError(f"missing UF2: {uf2_path}")

    before = lsusb_rp2_bootsel_devices()
    reboot = run_cmd(["picotool", "reboot", "-u", "-f", "--ser", usb_serial], check=True, capture_output=True)
    bus, addr = wait_for_new_rp2_bootsel_device(before, timeout_s=10.0)
    load = run_cmd(
        ["picotool", "load", "-x", uf2_path, "--bus", str(bus), "--address", str(addr)],
        check=True,
        capture_output=True,
    )
    if log_path is not None:
        lines = []
        lines.append(f"picotool reboot -u -f --ser {usb_serial}")
        if reboot.stdout:
            lines.append(reboot.stdout.strip())
        if reboot.stderr:
            lines.append(reboot.stderr.strip())
        lines.append(f"picotool load -x {uf2_path} --bus {bus} --address {addr}")
        if load.stdout:
            lines.append(load.stdout.strip())
        if load.stderr:
            lines.append(load.stderr.strip())
        log_path.write_text("\n".join(l for l in lines if l) + "\n", encoding="utf-8")


def picotool_reboot_application(usb_serial: str) -> None:
    # Start tests from a clean state (clears any latched safety/ESTOP state).
    # Uses picotool's "force" path so we don't need BOOTSEL or a power cycle.
    run_cmd(["picotool", "reboot", "-a", "-f", "--ser", usb_serial], check=True, capture_output=True)


def build_robot(repo_root: Path) -> None:
    run_cmd([str(repo_root / "tools" / "build.sh")], check=True, capture_output=False)


def build_gamepad(repo_root: Path) -> None:
    env = os.environ.copy()
    if "PICO_SDK_PATH" not in env or not env["PICO_SDK_PATH"]:
        env["PICO_SDK_PATH"] = str(Path.home() / "pico" / "pico-sdk")
    build_dir = repo_root / "controller_emulator" / "build"
    run_cmd(
        ["cmake", "-S", str(repo_root / "controller_emulator"), "-B", str(build_dir)],
        check=True,
        capture_output=True,
        env=env,
    )
    run_cmd(
        ["cmake", "--build", str(build_dir), "-j", str(os.cpu_count() or 4)],
        check=True,
        capture_output=False,
        env=env,
    )


def labctl_psu_off(channel: int) -> None:
    run_cmd(["labctl", "psu", "off", "--channel", str(channel)], check=False, capture_output=True)


def labctl_psu_set(channel: int, voltage: float, current: float) -> None:
    run_cmd(
        [
            "labctl",
            "psu",
            "set",
            "--channel",
            str(channel),
            "--voltage",
            str(voltage),
            "--current",
            str(current),
            "--on",
        ],
        check=True,
        capture_output=True,
    )


def labctl_psu_snapshot(channel: int) -> dict:
    result = run_cmd(["labctl", "--json", "psu", "snapshot", "--channel", str(channel)], check=True, capture_output=True)
    payload = json.loads(result.stdout or "{}")
    return payload


def labctl_psu_measure(channel: int, kind: str) -> float | None:
    # Use --json for stable parsing. Return None on any error/timeouts.
    result = run_cmd(
        ["labctl", "--json", "--timeout", "2.0", "psu", "measure", "--channel", str(channel), "--kind", kind],
        check=False,
        capture_output=True,
    )
    try:
        payload = json.loads(result.stdout or "{}")
    except json.JSONDecodeError:
        return None
    if not payload.get("ok"):
        return None
    text = payload.get("text")
    if text is None:
        return None
    try:
        return float(str(text).strip())
    except ValueError:
        return None


def now_iso() -> str:
    return datetime.now().isoformat(timespec="seconds")


def _load_expected_am32_config(config_path: Path) -> bytes:
    """Load expected AM32 config from .bin, hex text, or YAML, and validate it."""
    if not config_path.exists():
        raise RuntimeError(f"expected AM32 config not found: {config_path}")
    import am32_config_codec as codec

    if config_path.suffix.lower() in {".yaml", ".yml"}:
        image = codec.encode_yaml_to_image(codec.load_yaml_mapping(config_path))
    else:
        image = codec.parse_image(config_path)
    errors, _ = codec.validate_image(image)
    if errors:
        raise RuntimeError(f"{config_path}: invalid AM32 config: " + "; ".join(errors))
    return image


def _am32_diff_summary(expected: bytes, observed: bytes) -> dict[str, object]:
    if len(expected) != len(observed):
        raise RuntimeError(f"AM32 config length mismatch: expected {len(expected)} got {len(observed)}")
    diffs = [{"offset": i, "expected": expected[i], "observed": observed[i]} for i in range(len(expected)) if expected[i] != observed[i]]
    return {
        "size": len(expected),
        "diff_count": len(diffs),
        "first_diffs": diffs[:32],
    }


def _build_am32_service_firmware(repo_root: Path, out_dir: Path | None = None) -> Path:
    env = os.environ.copy()
    if "PICO_SDK_PATH" not in env or not env["PICO_SDK_PATH"]:
        env["PICO_SDK_PATH"] = str(Path.home() / "pico" / "pico-sdk")

    build_dir = repo_root / "firmware" / "tests" / "build"

    cfg = run_cmd(
        ["cmake", "-S", str(repo_root / "firmware" / "tests"), "-B", str(build_dir)],
        check=True,
        capture_output=True,
        env=env,
    )
    bld = run_cmd(
        ["cmake", "--build", str(build_dir), "-j", str(os.cpu_count() or 4), "--target", "am32_flasher_service"],
        check=True,
        capture_output=True,
        env=env,
    )

    if out_dir is not None:
        (out_dir / "build_am32_service_configure.log").write_text(
            (cfg.stdout or "") + ("\n" + cfg.stderr if cfg.stderr else ""),
            encoding="utf-8",
        )
        (out_dir / "build_am32_service_build.log").write_text(
            (bld.stdout or "") + ("\n" + bld.stderr if bld.stderr else ""),
            encoding="utf-8",
        )

    uf2 = build_dir / "am32_flasher_service.uf2"
    if not uf2.exists():
        raise RuntimeError(f"am32_flasher_service UF2 not found after build: {uf2}")
    return uf2


def _run_am32_flasher_cmd(
    repo_root: Path,
    port: str,
    cmd_args: list[str],
    *,
    retries: int = 4,
    retry_delay_s: float = 1.0,
) -> tuple[subprocess.CompletedProcess, list[dict[str, object]]]:
    flasher_py = repo_root / "tools" / "am32_pico_flasher.py"
    if not flasher_py.exists():
        raise RuntimeError(f"missing AM32 flasher tool: {flasher_py}")

    attempts: list[dict[str, object]] = []
    last_detail = "unknown error"
    full_cmd = [sys.executable, str(flasher_py), "--port", port, *cmd_args]

    for attempt in range(1, max(1, retries) + 1):
        result = run_cmd(full_cmd, check=False, capture_output=True)
        detail = ((result.stderr or "").strip() or (result.stdout or "").strip() or "unknown error")
        attempts.append(
            {
                "attempt": attempt,
                "returncode": result.returncode,
                "stdout": result.stdout or "",
                "stderr": result.stderr or "",
            }
        )
        if result.returncode == 0:
            return result, attempts

        last_detail = detail
        is_retryable = (
            "ESC not in bootloader mode" in detail
            or "Timed out" in detail
            or "timeout" in detail.lower()
            or "ERR ENTER" in detail
        )
        if attempt < retries and is_retryable:
            time.sleep(retry_delay_s)
            continue
        raise RuntimeError(f"command failed: {' '.join(full_cmd)}\n{detail}")

    raise RuntimeError(f"command failed after retries: {' '.join(full_cmd)}\n{last_detail}")
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
