stevemance/thumbsup/firmware/tests/src/am32_raw_probe.c

#include <stdio.h>
#include <string.h>

#include "pico/stdlib.h"
#include "hardware/gpio.h"
#include "hardware/sync.h"

#define AM32_PIN 4

#define ENTRY_PULSES 10
#define ENTRY_PULSE_US 100
#define ENTRY_GAP_US 900

static bool tx_push_pull = false;
static uint32_t bit_us = 52;
static uint32_t half_bit_us = 26;

static void set_baud(uint32_t baud) {
    if (baud == 0) {
        baud = 19200;
    }
    bit_us = (1000000u + (baud / 2u)) / baud;
    if (bit_us == 0) {
        bit_us = 1;
    }
    half_bit_us = bit_us / 2u;
    if (half_bit_us == 0) {
        half_bit_us = 1;
    }
}

static inline void line_low(void) {
    gpio_set_dir(AM32_PIN, GPIO_OUT);
    gpio_put(AM32_PIN, 0);
}

static inline void line_high(void) {
    gpio_set_dir(AM32_PIN, GPIO_OUT);
    gpio_put(AM32_PIN, 1);
}

static inline void line_release(void) {
    gpio_set_dir(AM32_PIN, GPIO_IN);
    gpio_pull_up(AM32_PIN);
}

static inline void line_tx_one(void) {
    if (tx_push_pull) {
        line_high();
    } else {
        line_release();
    }
}

static void tx_byte(uint8_t byte) {
    uint32_t irq = save_and_disable_interrupts();
    line_low();
    busy_wait_us_32(bit_us);
    for (int i = 0; i < 8; i++) {
        if ((byte >> i) & 1u) {
            line_tx_one();
        } else {
            line_low();
        }
        busy_wait_us_32(bit_us);
    }
    line_tx_one();
    busy_wait_us_32(bit_us);
    line_release();
    restore_interrupts(irq);
}

static int rx_byte(uint32_t timeout_us) {
    uint32_t start = time_us_32();
    line_release();

    // Require idle-high.
    while (!gpio_get(AM32_PIN)) {
        if ((time_us_32() - start) > timeout_us) {
            return -1;
        }
        tight_loop_contents();
    }
    // Wait for start low.
    while (gpio_get(AM32_PIN)) {
        if ((time_us_32() - start) > timeout_us) {
            return -1;
        }
        tight_loop_contents();
    }

    uint32_t irq = save_and_disable_interrupts();
    busy_wait_us_32(bit_us + half_bit_us);
    if (gpio_get(AM32_PIN)) {
        restore_interrupts(irq);
        return -2;
    }
    uint8_t v = 0;
    for (int i = 0; i < 8; i++) {
        if (gpio_get(AM32_PIN)) {
            v |= (uint8_t)(1u << i);
        }
        busy_wait_us_32(bit_us);
    }
    bool stop_high = gpio_get(AM32_PIN);
    restore_interrupts(irq);
    if (!stop_high) {
        return -3;
    }
    return (int)v;
}

static uint8_t xor_checksum(uint8_t cmd, const uint8_t* payload, uint16_t len) {
    uint8_t c = cmd ^ (uint8_t)(len & 0xFFu) ^ (uint8_t)(len >> 8);
    for (uint16_t i = 0; i < len; i++) {
        c ^= payload[i];
    }
    return c;
}

static void send_frame(uint8_t cmd, const uint8_t* payload, uint16_t len) {
    uint8_t c = xor_checksum(cmd, payload, len);
    tx_byte(cmd);
    tx_byte((uint8_t)(len & 0xFFu));
    tx_byte((uint8_t)(len >> 8));
    for (uint16_t i = 0; i < len; i++) {
        tx_byte(payload[i]);
    }
    tx_byte(c);
}

static bool read_response(uint8_t* out, uint16_t out_cap, uint16_t* out_len, uint32_t timeout_us) {
    if (!out || !out_len || out_cap == 0) {
        return false;
    }
    int h0 = rx_byte(timeout_us);
    if (h0 < 0) {
        return false;
    }
    int h1 = rx_byte(timeout_us);
    if (h1 < 0) {
        return false;
    }
    uint16_t len = (uint16_t)((uint16_t)h0 | ((uint16_t)h1 << 8));
    if (len == 0) {
        *out_len = 0;
        return true;
    }
    if (len > out_cap) {
        return false;
    }
    for (uint16_t i = 0; i < len; i++) {
        int b = rx_byte(timeout_us);
        if (b < 0) {
            return false;
        }
        out[i] = (uint8_t)b;
    }
    *out_len = len;
    return true;
}

static uint32_t count_edges(uint32_t duration_us) {
    uint32_t edges = 0;
    uint32_t start = time_us_32();
    bool last = gpio_get(AM32_PIN);
    while ((time_us_32() - start) < duration_us) {
        bool now = gpio_get(AM32_PIN);
        if (now != last) {
            edges++;
            last = now;
        }
    }
    return edges;
}
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
