stevemance/thumbsup/(commit log)

2025-09-16 Initial commit: Complete antweight robot control system
    Features:
    - Raspberry Pi Pico W based control system
    - Bluetooth gamepad support (PB Tails Crush/Xbox 360)
    - Differential drive with exponential curves
    - Variable speed weapon control with safety features
    - Integrated AM32 ESC programming via PWM line
    - Multiple safety systems and failsafes
    - Comprehensive documentation and tools
    Hardware support:
    - 2ch brushed drive motors
    - Brushless weapon motor with AM32 ESC
    - Battery monitoring and protection
    - Status LED indicators
    - Optional safety button
    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
    [antweight-robot.kicad_sch]
2025-09-16 refactor: Complete rebranding from antweight-robot to thumbsup
    - Updated all firmware binary names to thumbsup.uf2
    - Renamed KiCad project files
    - Updated all documentation references
    - Fixed all build scripts and tools
    - Ensures consistent naming throughout the project
    [thumbsup.kicad_sch]
2025-09-16 feat: Integrate Bluepad32 for Bluetooth gamepad support
    - Replace custom bluetooth implementation with Bluepad32
    - Add bluetooth_platform.c as Bluepad32 platform implementation
    - Update CMakeLists.txt to match pico_controller configuration
    - Use Bluepad32's BTstack with proper configuration
    - Successfully builds and generates UF2 file
    The firmware now uses Bluepad32 for gamepad support, providing
    better controller compatibility and event-driven architecture.
    [bluetooth_platform.c, btstack_config.h, main.c]
2025-09-17 feat: Enhance safety systems for combat robot operation
    - Add comprehensive safety test suite that runs at startup
    - Implement continuous safety monitoring with violation counting
    - Add emergency stop hold time requirement (2 seconds) to prevent accidental resets
    - Improve integer overflow protection in all motor control calculations
    - Add battery voltage validation before weapon arming
    - Enhance failsafe timeout handling with increased reliability (1500ms)
    - Add safety_test module with 6 critical safety validation tests
    - Improve logging and error handling throughout safety-critical paths
    - Fix btstack_run_loop integration to work correctly with Bluepad32
    Safety improvements ensure robot c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
    [am32_config.c, bluetooth_platform.c, config.h, drive.c, main.c, motor_control.c, safety.c, safety_test.c]
2025-09-17 docs: Add comprehensive user manual and safety documentation
    - Create detailed USER_MANUAL.md with complete operating instructions
    - Add QUICK_REFERENCE.md for competition use
    - Document all 6 startup safety tests and their pass/fail criteria
    - Detail controller mappings and control functions
    - Add LED indicator reference guide
    - Include emergency procedures and troubleshooting
    - Add battery management guidelines
    - Create competition checklist
    - Update README with safety features overview and documentation links
    Manual covers all aspects of safe robot operation including startup
    procedures, safety test interpretation, and emergency response.
2025-09-17 feat: Add diagnostic mode with web dashboard (currently disabled)
    - Implement dual-mode system: Competition (Bluetooth) and Diagnostic (WiFi)
    - Create comprehensive web dashboard with real-time telemetry
    - Add virtual joystick control interface for drive testing
    - Implement weapon control with safety interlocks
    - Add event logging system with timestamps
    - Create JSON API for telemetry and control endpoints
    - Build responsive HTML/CSS/JS dashboard interface
    - Add mode selection at boot (hold safety button 3 seconds)
    - Currently disabled due to WiFi/Bluetooth coexistence limitations
    The diagnostic mode provides powerful debugging capabilities including:
    - Real-time system monitoring (CPU, mem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
2025-09-17 fix: Address all critical issues and implement improvements from code review
    Critical fixes:
    - Move CLAMP/MIN/MAX macros to config.h to fix compilation issues
    - Fix duplicate variable declaration in switch case by adding scope braces
    - Fix integer division precision loss in weapon ramping using float calculation
    - Add watchdog timer with 1-second timeout and periodic feeding
    - Replace all magic numbers with named constants
    - Remove extern declarations and use proper header includes
    Improvements:
    - Add bluetooth_platform.h header for function declarations
    - Create error_codes.h with standardized error handling system
    - Add constants for all hold times and thresholds
    - Improve safety monitori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
    [bluetooth_platform.c, bluetooth_platform.h, config.h, error_codes.h, main.c, motor_control.c, motor_control.h, safety.c]
2025-09-17 docs: Add comprehensive hardware setup guide
    - Create detailed HARDWARE_SETUP.md with complete pinout diagram
    - Document safety button configuration and usage
    - Add voltage divider circuit for battery monitoring
    - Include LED indicator meanings and states
    - Document power requirements and wiring best practices
    - Add testing procedures and troubleshooting guide
    - Clarify that safety button is optional but recommended
    - Explain diagnostic mode hardware requirements
    The safety button (GP8) is already configured in the code and serves
    multiple purposes:
    1. AM32 ESC configuration mode entry
    2. Diagnostic mode entry (when enabled)
    3. Runtime weapon disarm
    All pin assignments are already in confi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
2025-09-18 feat: Add interactive controller test mode with proper IMU calibration
    - Implemented test mode activated by holding L+R shoulder buttons for 1 second
    - Real-time display of all controller inputs using ANSI terminal control
    - Proper gyroscope scaling based on Nintendo Switch reverse engineering docs
    - Raw sensor values multiplied by 0.070 for deg/s conversion
    - Accounts for Bluepad32's 1000x scaling factor
    - Applied bias correction for zero drift when stationary
    - Accelerometer calibrated to show proper g-forces and m/s²
    - Fixed button debouncing issue for weapon arm/disarm
    - Fixed watchdog timer chicken-egg problem (enabled after first controller connection)
    - Fixed integer overflow i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
    [bluetooth_platform.c, test_mode.c, test_mode.h]
2025-10-07 fix: Add missing motor_control_update() and weapon_update() calls in competition mode
    Critical bug fix: The motor control system was setting target PWM values but
    never actually updating the hardware outputs. This caused GP2, GP3, and GP4
    to show no PWM activity.
    Added motor_control_update() and weapon_update() calls to the Bluepad32
    on_controller_data callback to ensure PWM values are properly applied to
    the hardware on each controller input update.
    This fixes:
    - No PWM output on drive motor pins (GP2, GP3)
    - No weapon motor control (GP4)
    - Weapon ramping not functioning
    [bluetooth_platform.c, config.h, lwipopts.h, main.c, motor_control.c, system_status.h]
2025-11-11 feat: Migrate to GP0-2 PWM pins and implement SK6812 addressable LED status system
    Hardware Changes:
    - Move drive motors to GP0 (left) and GP1 (right)
    - Move weapon motor to GP2
    - Add SK6812 addressable LEDs on GP3 (2 LEDs)
    - Remove individual status LED pins (GP5-7)
    LED Status System:
    - LED 0 (System): Boot, Ready, Connected, Failsafe, Battery, Error, E-Stop, Test Mode
    - LED 1 (Weapon): Disarmed, Arming, Armed, Spinning, E-Stop
    - Effects: Solid, blink (slow/med/fast), pulse, fade
    - Color-coded feedback: Blue=boot, Green=ready, Cyan=connected, Yellow=failsafe,
    Orange=low battery, Red=critical/error/spinning, Purple=test mode
    Implementation:
    - Add WS2812/SK6812 PIO driver using RP2040 PIO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
    [bluetooth_platform.c, config.h, main.c, status.c, status.h, test_mode.c, weapon.c, ws2812.c]
2025-11-11 feat: Implement dual-point motor trim calibration mode with flash persistence
    Motor Trim Calibration System:
    - Two-point calibration at 30% and 70% power to handle motor non-linearity
    - Automatic interpolation between calibration points during normal operation
    - Persistent flash storage of trim values (survives power cycles)
    - Entry/Exit: Hold L3+R3 (both joystick buttons) for 2 seconds
    Calibration Workflow:
    1. Enter trim mode (L3+R3 hold 2s)
    2. Robot drives forward at locked 30% speed
    3. Use left stick X-axis to steer until robot goes straight
    4. Press Y button to advance to 70% power
    5. Repeat steering adjustment at 70% speed
    6. Exit trim mode (L3+R3 hold 2s) to save both values
    Implemen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
2025-11-11 fix: Add missing includes to resolve compilation warnings
    - Add <stdlib.h> to drive.c for abs() function
    - Add pico/time.h to ws2812.c for sleep_us() function
    Build now completes cleanly with no warnings.
    [drive.c, ws2812.c]
2025-11-12 fix: Correct trim mode gamepad input scaling and remove expo curves
    Trim Mode Bug Fixes:
    1. Fixed gamepad axis scaling in bluetooth_platform.c
    - Was passing raw gamepad values (-512 to +511) directly to drive_update()
    - Now properly scales to -127..+127 range with deadzone handling
    - Caused validation failures and motor stoppage in trim mode
    2. Removed expo curves and speed limits in trim mode (drive.c)
    - Changed trim mode to use direct linear motor control
    - Robot now drives at exactly 30% or 70% power as intended
    - Turn input provides pure tank-style steering: left=fwd+turn, right=fwd-turn
    - No expo curves applied during calibration for precise adjustment
    Result: Tri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
    [bluetooth_platform.c, drive.c]
2025-11-12 fix: Improve trim mode resolution and prevent motor reversal
    Fixed trim calibration to use full X-axis range while preventing motors from
    stopping or reversing during calibration.
    Changes:
    - Added MIN_MOTOR_SPEED constant (5%) to ensure motors always move forward
    - Calculate max_turn dynamically: forward_percent - MIN_MOTOR_SPEED
    - Map full stick range (-127..+127) to safe turn range (±max_turn)
    - This maximizes trim adjustment resolution
    Behavior:
    - At 30% forward: Turn range ±25% → motors stay between 5-55%
    - At 70% forward: Turn range ±65% → motors stay between 5-100%
    - Full X-axis travel now maps to maximum safe trim range
    - Both motors always maintain forward motion during cali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
    [drive.c]
2025-11-12 fix: Resolve critical expo curve bug causing inverted drive directions
    CRITICAL BUG FIX:
    - Fixed drive_apply_expo() double-inversion bug that was inverting all negative
    inputs (backward stick) to positive values (forward commands)
    - The expo curve was incorrectly inverting output when input < 0, but cubic
    functions naturally preserve sign (negative³ = negative)
    - This caused robot to only drive in one direction regardless of stick input
    CHANGES:
    - Removed erroneous sign inversion in drive.c:drive_apply_expo()
    - Added comprehensive debug logging throughout signal chain (controller → PWM)
    - Confirmed RIGHT motor reversal flag needed for opposite-facing motor mount
    - Verified ESC mixing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
    [bluetooth_platform.c, config.h, drive.c, motor_control.c, status.c]
2025-11-12 feat: Comprehensive control system improvements with real-unit integration
    PROBLEM:
    User reported "transition from slow speed to fast speed is way too abrupt
    and it's difficult to control." Root cause identified as high power-to-
    weight ratio (27:1 thrust-to-weight) combined with insufficient expo curve.
    SOLUTION IMPLEMENTED:
    1. **Increased expo from 30% to 70%** for dramatically improved low-speed control
    - Center stick sensitivity: 0.70 → 0.30 (2.3x better)
    - Quarter stick sensitivity: 0.61 → 0.16 (3.8x better)
    - Provides finer control at low speeds while maintaining full speed capability
    2. **Added real-world unit integration** to firmware
    - Motor specs: 1220 RPM max, 1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
    [config.h, drive.c]
2025-11-13 feat: Add motor linearization system with automated calibration mode
    This commit implements a comprehensive motor control improvement system to address the reported "incredibly difficult to drive" issue, particularly during slow flat spins where the robot didn't rotate on center due to motor asymmetry.
    ## New Features
    ### Automated Calibration Mode
    - Hold X+Y buttons to enter/exit calibration mode
    - Automatically steps through 23 PWM values (0%, 10-100% forward, 0%, -10 to -100% reverse, 0%)
    - Press A button to advance to next step
    - User manually logs left/right wheel RPMs at each step using optical tachometer
    - Calibration data collected in forward.csv and reverse.csv
    ### Per-Motor Line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
    [forward.csv, reverse.csv]
2025-11-18 fix: Address all critical and major issues from code review
    - Fix AM32 checksum algorithm to standard XOR of all bytes
    - Fix PIO state machine race condition with dynamic allocation
    - Fix DShot deinit to use reference counting for shared programs
    - Fix mode assignment atomicity in weapon control (already present)
    - Add comprehensive AM32 protocol documentation
    - Add hardware testing requirements documentation
    Major fixes:
    - Add max length validation (512 bytes) for AM32 responses
    - Increase EEPROM write delay from 100ms to 500ms
    - Fix DMA channel leak on PIO program add failure
    - Add documentation for EDT parsing assumptions and ESC variations
    - Add comment explaining static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
    [am32_config.c, am32_config.h, dshot.c, dshot.h, weapon.c]
2025-11-18 fix: Critical DShot timing bug and GPIO conflicts - Iteration 2
    - Fix DShot PIO timing from 13 to 15 cycles (13.3% error corrected)
    The PIO instruction count was missing 'out y,1' and 'jmp !y,bit_zero'
    Updated calculations for all DShot speeds (150/300/600/1200)
    - Add explicit GPIO ownership handoff between PWM/DShot/Config modes
    Prevents hardware register conflicts when switching control modes
    Disables PWM slice and resets GPIO to SIO before mode transitions
    - Document AM32 bidirectional UART hardware requirements
    Added prominent warning about TX/RX wiring requirements
    Added runtime validation to detect missing RX connection
    - Add DMA transfer compl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
    [am32_config.c, dshot.c, weapon.c]
2025-11-18 fix: Iteration 3 - GPIO conflicts, DMA timeout, emergency stop safety
    Addresses 8 CRITICAL and MAJOR code-addressable issues from independent review:
    CRITICAL FIXES:
    - #1: GPIO resource conflicts between DShot/AM32 UART
    * Add 2ms hardware settling delays after gpio_set_function()
    * Verify GPIO is in SIO state before claiming for new mode
    * Prevent simultaneous peripheral access to GP4
    - #2: Missing timeout on blocking DMA wait (SAFETY CRITICAL)
    * Replace dma_channel_wait_for_finish_blocking() with 50ms timeout
    * Abort DMA transfer on timeout to prevent system freeze
    * Ensures emergency stop remains responsive
    MAJOR FIXES:
    - #3: AM32 RX validation already mandatory (verified)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
    [am32_config.c, dshot.c, weapon.c]
2025-11-18 fix: Iteration 4 - Race conditions, buffer overflows, synchronization
    This commit addresses all 4 CRITICAL and 7 MAJOR code quality issues
    identified in the final pre-hardware testing review.
    CRITICAL-1: Race condition in weapon_emergency_stop()
    - Changed from mode-dependent stop to defense-in-depth approach
    - Now executes ALL stop methods (PWM, DShot, GPIO) regardless of mode
    - Prevents race where mode could change between read and execution
    - Ensures motor stops even if one method fails
    CRITICAL-2: Unprotected dshot_initialized flag access
    - Made dshot_initialized volatile to prevent compiler reordering
    - Flag already protected by mode_mutex in all modification paths
    - P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
    [thumbsup.kicad_sch]
2025-11-18 fix: Configure for F2822-1100KV motor - CRITICAL current limit fix
    - CRITICAL: Reduce current limit from 40A to 10A (motor max 9.9A)
    - Lower temperature limit to 70°C (conservative for small motor)
    - Enable brake on stop for weapon safety
    - Reduce startup power to 5 (gentler on small motor)
    - Add hardware configuration analysis document
    Motor: FingerTech Silver Spark F2822-1100KV (0.125" shaft)
    ESC: AT32F421-based AM32 ESC
    Max current: 9.9A, Max power: 102W, Max voltage: 11.1V (3S)
    WARNING: Previous 40A limit would destroy this motor!
    All settings now match motor specifications.
    [am32_config.c]
2025-11-18 docs: Add comprehensive hardware bringup plan
    Complete testing protocol for weapon motor system including:
    - ESC configuration with parameter adjuster
    - DShot protocol verification with oscilloscope
    - Motor characterization and thermal testing
    - EDT telemetry validation
    - Battery operation testing
    - Full robot integration
    - Competition preparation checklist
    Designed for Siglent SDS1202X-E oscilloscope and bench power supply.
    Includes safety procedures, troubleshooting guide, and data sheets.
2025-11-18 docs: Comprehensive cleanup of documentation directory
    DELETED (6 files - outdated/redundant):
    - wiring_guide.md: Outdated pin assignments (GP2→GP4), wrong LED info (individual vs SK6812)
    - am32_programming.md: Redundant, fully covered by AM32_INTEGRATION.md
    - CONTROL_ANALYSIS.md: Historical analysis doc, superseded by implementation
    - CONTROL_IMPROVEMENTS_SUMMARY.md: Historical changelog, no longer needed
    - TURNING_DYNAMICS.md: Design analysis doc, key info preserved in other docs
    - CALIBRATION_REPORT.md: One-time calibration data, not reference material
    UPDATED (4 files - fixed inaccuracies):
    - HARDWARE_SETUP.md:
    * Fixed weapon pin: GP2 → GP4 (correct pin for UART1/DShot)
    * Update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
2025-11-18 refactor: Comprehensive code cleanup and DShot enablement
    CRITICAL FIX: Enable DShot by default for weapon motor
    - Weapon now defaults to DShot300 mode (was PWM)
    - Hardware is configured for DShot on GP4
    - Provides faster response, digital protocol, and telemetry
    - Automatic fallback to PWM if DShot init fails
    Removed diagnostic mode (WiFi web server):
    - Deleted diagnostic_mode.c, web_server.c, dhcp_server.c
    - Deleted related headers
    - Removed WiFi/HTTP server code from main.c
    - Cleaned up CMakeLists.txt conditional build logic
    - Competition mode (Bluetooth) is now the only build target
    - Diagnostic mode was incomplete and unused
    Removed dead test file:
    - Deleted test_wifi.c (standalone te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
    [am32_config.c, dshot.c, main.c, weapon.c]
2025-12-05 fix: Critical bug fixes and code cleanup from code review
    ## Bug Fixes
    1. **ws2812.c**: Fixed unsigned/signed type mismatch for PIO state machine
    - Changed `uint sm` to `int sm` so -1 error check from pio_claim_unused_sm works
    2. **main.c**: Removed duplicate stdio_init_all() call
    - Was being called twice (in init_hardware and main), now only in main()
    3. **bluetooth_platform.c**: Added critical safety_update() call
    - CRITICAL: safety_update() was never called - battery/button monitoring was inactive
    - Now called in main control loop for continuous safety monitoring
    4. **bluetooth_platform.c**: Fixed emergency stop clear logic
    - Only process A button for clearing when emer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
    [bluetooth_platform.c, dshot.c, main.c, ws2812.c]
2026-02-06 Add Pico W controller emulator skeleton
2026-02-06 Label HITL USB devices for easier identification
2026-02-06 Add HITL device setup docs and prefer stable tty aliases
2026-02-06 Add HITL orchestration framework
2026-02-06 Make weapon_spin suite verify spin via PSU current
    - Add PSU current sampling + spin result artifacts to hitl_orchestrator
    - Raise default DShot update rate (500Hz) and switch weapon to unidirectional DShot for reliable spin
2026-02-07 hitl: fix e-stop PWM; avoid BT races; improve connect
    [bluetooth_platform.c, hitl_orchestrator.py]
2026-02-07 hitl: full e2e suite; fix gamepad right stick; hard stop on disconnect
    [bluetooth_platform.c, hitl_orchestrator.py, main.c]
2026-02-07 hitl: make drive stop-current check robust (tail median)
2026-02-08 docs: fix pin table in README
2026-02-08 competition: prevent startup drive lurch; fix weapon arming throttle
    [bluetooth_platform.c, integration_test.c, weapon.c]
2026-02-08 safety: stop startup motor command; improve weapon input mapping
2026-02-09 hitl: fix BT sniff latency; improve weapon telemetry + latency test
    [bluetooth_platform.c, config.h, hitl_console.c, hitl_orchestrator.py, hitl_report.py, main.c, serial_gamepad.c, weapon.c]
2026-02-09 hitl: extend weapon latency drift test (axis sequence)
    [hitl_orchestrator.py, hitl_report.py]
2026-02-09 competition: fix weapon stick range dropouts
    [bluetooth_platform.c]
2026-02-10 weapon: fix zero-crossing reversal speed, armed_state desync, and reduce arm time
    - Add reversal_active flag to weapon ramp logic so direction reversals
    use the fast spindown rate for both phases (~409ms vs ~1520ms).
    - Sync armed_state with weapon_state in bluetooth_platform.c to fix the
    "never spins" bug where internal emergency_stop leaves armed_state
    stale, causing weapon_set_speed() to silently fail.
    - Reduce WEAPON_ARM_TIMEOUT from 5000ms to 500ms (DShot setup is already
    done at boot, so 500ms zero-throttle window is sufficient for ESC arm).
    - Add weapon_zero_cross HITL test suite that validates direction reversal
    timing and detects stuck-at-zero conditions.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
    [bluetooth_platform.c, config.h, dshot.c, dshot.h, hitl_console.c, hitl_console.h, hitl_orchestrator.py, hitl_report.py]
2026-02-10 weapon: fix direction change startup failure with AM32 prime sequence
    The AM32 ESC's sensorless startup fails on the first attempt at a new
    direction in 3D mode: the direction-change code sets old_routine=1,
    which skips startMotor() and leaves stale BEMF commutation state.
    Sending DShot=0 triggers the BEMF timeout (22.5ms) and resets the ESC's
    running state; the next throttle command starts cleanly because the
    direction flag was already flipped on the first (failed) attempt.
    Add a 2-phase "prime" sequence that fires on every start from zero:
    Phase 1 (20ms): send new direction's minimum DShot value to flip the
    ESC's internal direction flag without spinning the motor.
    Phase 2 (30ms):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
    [bluetooth_platform.c, config.h, hitl_orchestrator.py, main.c, safety.c, safety_test.c, weapon.c]
2026-02-11 repo cleanup: remove build artifacts, dead files, verbose comments; add user manual
    - Remove 89 tracked build_diagnostic/ files and root calibration clutter from git
    - Delete obsolete tools (flash.sh, build_modes.sh, am32_config.py) and stale docs
    - Strip archaeological comment prefixes from firmware (dshot.c, weapon.c, am32_config.c)
    - Extract shared Python utilities into tools/common.py, deduplicate across 7 tool scripts
    - Fix CI workflow: add Bluepad32 checkout step
    - Fix .claude.md weapon pin reference (GP2 → GP4)
    - Remove all diagnostic mode references from docs and README
    - Add comprehensive user manual (docs/USER_MANUAL.md)
    [forward.csv, reverse.csv]
2026-09-30 am32: provision the weapon ESC from the Pico; enable 70 C limit
    Pico-hosted AM32 bootloader tooling (Feb 2026 work): the am32_flasher_service
    test firmware speaks the AM32 bootloader protocol on the signal wire, and
    tools/am32_pico_flasher.py drives it to probe the ESC, read/write the EEPROM
    config and program Intel HEX images. tools/am32_config_codec.py converts
    between the YAML and the raw EEPROM image, and config/am32/weapon_esc_expected.*
    is the canonical config the HITL orchestrator applies on drift.
    The expected config now enables the ESC's 70 C temperature limit (was 255,
    disabled). The rig ESC (FREELYRC_F421, AM32 2.20) was re-provisioned and read
    back with zero differences. The cur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
    [am32_bootloader.c, am32_bootloader.h, am32_bootloader_probe.c, am32_config.c, am32_config_codec.py, am32_flasher_service.c, am32_onewire_probe.c, am32_pico_flasher.py]
2026-09-30 controller_emulator: fix HID registration, add latency marker and PAUSE
    - btstack_config: MAX_NR_L2CAP_SERVICES 3 / CHANNELS 4 (was 2/3); the HID
    control PSM silently failed to register, so hosts could never connect.
    - GP15 latency marker: driven high while the report being sent carries a
    deflected stick or a held ZL/ZR, for the HITL logic analyzer (M2K DIO0).
    - PAUSE <ms>: stop sending reports with the link up, to test the robot's
    report-age failsafe.
    - HITL SENT lines include the button state.
    [btstack_config.h, main.c]
2026-09-30 firmware: cut control latency, split-stick + trigger weapon, rewrite ESC telemetry
    Measured on the HITL rig with GP15 markers and an ADALM2000 (stick -> motor
    voltage): ~130-170 ms before, ~53-64 ms median after.
    Latency
    - Bluetooth: request 1.25 ms poll latency (QoS, with Best Effort / Flow Spec
    fallbacks) and ask the controller to take the central role; the PB Tails
    Crush rejects QoS, and as central its 20-45 ms report gaps drop from ~10%
    to 0.2%. Link role/mode/QoS events are logged.
    - Drive: remove the per-call slew limiter (added 20-40 ms); drive PWM on a
    1 MHz tick at 100 Hz. The Kingmodel SAX2 waits ~5 frames before reacting
    and ignores >=160 Hz, so its delay halves at 100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
2026-09-30 am32: make Pico-based ESC flashing safe; validate backup and round-trip
    A review of the flashing path found the ESC bootloader (AM32 F421 PB4 V4)
    ACKs flash writes without checking them, a 1 KB-aligned write erases the
    whole page, the service had no address guard, and a rejected payload leaves
    the bootloader expecting data. Fixes:
    - service FLASH: refuse writes outside 0x1000-0x7FFF or not word aligned
    (without contacting the ESC), and read every write back, replying OK only
    on an exact match;
    - bootloader driver: resync with KEEP_ALIVE after a rejected payload;
    - am32_pico_flasher.py: host read-back verify on by default (--no-verify to
    skip), non-zero exit when nothing is flashable, r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
    [am32_bootloader.c, am32_flasher_service.c, am32_pico_flasher.py]
2026-09-30 am32: make ESC config writes safe; clean up the weapon ESC config
    From the flashing-path review (codec and provisioning findings):
    - codec: YAML must be complete (partial files were silently completed from
    defaults such as brake-on-stop on and a garbage startup tune); compile
    refuses byte 0 != 0x01 (the ESC would stay in its bootloader) and layouts
    other than eeprom_version 3, and warns on booleans that are not 0/1,
    sine start with comp PWM off, and current limits (2 A steps).
    - write-config: AM32 bootloaders have no EEPROM command, so this is now an
    explicit full-page rewrite: validate, refuse a firmware/layout version
    mismatch (--force-version to override), save the current pag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
2026-09-30 weapon: keep the ESC from stranding in its bootloader; recover it if it does
    Root cause of the intermittent "weapon never spins" failure: the ESC's AM32
    bootloader (F421 PB4 V4) samples the signal line for ~10 ms at power-up and,
    if it only sees high, stays in the bootloader and ignores DShot until the ESC
    is power-cycled. The disarmed robot idled the line high with sparse DShot
    frames (only every 10 ms before a controller pairs), so power-ups failed
    intermittently. On the rig: line high 0/10 boots, line low 5/5; brown-outs
    while armed stranded the ESC 4 times in 15.
    - Disarmed: no frames and the signal is driven low (dshot_set_output_paused),
    so the ESC always starts its firmware; frames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
    [config.h, dshot.c, dshot.h, hitl_console.c, integration_test.c, serial_gamepad.c, weapon.c, weapon.h]
2026-09-30 Low-battery alerts from ESC voltage; fix ESC setup timing; e-stop drive latch
    Battery monitor (alert only, never limits anything): smooths the weapon ESC's
    voltage telemetry (5 s time constant, so spin-up sag does not trip it) and
    raises LOW below 10.2 V and CRITICAL below 9.6 V, with 0.3 V hysteresis.
    Alerts: controller rumble (2 pulses on LOW, 3 on CRITICAL, repeated every
    30 s while critical), the controller's player LEDs as a 4-step gauge
    (updated only on change, since each update is a controller subcommand), and
    the system LED (orange / red blinking), taken over only from the normal
    connected state. The ESC reports voltage only while the weapon is armed; the
    last level is kept while dis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
    [battery_monitor.c, battery_monitor.h, bluetooth_platform.c, bluetooth_platform.h, config.h, hitl_console.c, weapon.c]
2026-10-02 drive: DRV8874 H-bridge drive with wheel speed, wheel health and speed matching
    Replaces the SAX2 RC ESC drive (still selectable with DRIVE_HBRIDGE 0) with two
    DRV8874 carriers driven directly by the Pico:
    - 20 kHz slow-decay (drive/brake) PWM on GP0-3; zero stick brakes
    (drag-brake fraction configurable); SLEEP (GP6) low until a controller is
    ready; nFAULT (GP7) counted and logged (rate limited).
    - Continuous ADC round robin into a DMA ring: both current senses and the
    battery divider (GP28, 100k/20k, now the battery source for alerts).
    - Back-EMF wheel speed estimate (handles IPROPI's low-side-only sensing).
    Winding resistance from starts from rest and from every drive->brake
    tr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
    [battery_monitor.c, battery_monitor.h, bluetooth_platform.c, config.h, drive.c, drive_hbridge.c, drive_hbridge.h, hitl_console.c]
